ayushgupta9906/Effi-QUI-ADAS-Four-Wheel-Fully-Electric-Vehicle---TGW-ZHCET/23056_Green Warriors_Document Package (1)/23056_Green Warriors_Document Package/23056_Green Warriors_Cost Report.xls

Sheet: Guidelines
Cost Report Guidelines
1. Introduction
1.1 | The cost report is a tool provided with the objective to calculate the cost of the Efficycle. (For this purpose teams can assume that the same Efficycle is manufactured by a fictitious firm.)
1.2 | The cost of vehicle should be calculated for all the fabrication work including the work which is done by the team itself. This also includes cost of the old parts used in vehicle. For such parts, the current cost of the same part in market must be entered in the Cost Report.
1.3 | Teams should calculate the cost of the efficycle considering the process time, material cost and manpower etc in the project in this Cost Report. Thhe reference of the cost estimation report prepared earlier may be taken while preparing this report.
2. Cost Report Data
2.1 | Definitions
2.1.1 | Block:
 | The whole efficycle can be considered as an assembly of various subsystems (e.g. Frame, drivetrain, suspension, steering, brakes, electrical circuits etc). These subsystems are defined as block in this Cost Report. The blocks are mentioned in the "INDEX SHEET" itself and same blocks must be used in the "BOM Sheet and Part List Sheet".
2.1.2 | Part Name:
 | The name of each part must be provided in the Part Name Column. The description is required to identify the unique part among same category of parts. (for example: if 2 different sizes of fasteners are used in the assembly of a subsystem like bolts of M10 and M12, then the part name must be given like "Fastener" for both with their description in the Remarks Column as "Bolt M10" and "Bolt M12" respectively). In case, only one part of its own type is being used then the description is not required. (for example: Motor)
2.1.3 | Quantity:
 | Quantity denotes how many times the same part is used in a block. For the same part the costs are calculated by applying quantity. (if teams are using 3 sprockets of same specification and same cost, then it must be considered as the single part whereas quantity will be 3)
2.1.4 | Procurement Cost:
 | Procurement cost are the cost of part/material purchased directly from the market. Procurement costs are considered per item or per unit quantity only in the Cost Report. If the parts are procured in lot or mass, then per item cost will be calculated by dividing the number of parts or amount of material to the total procurement cost of that lot.
2.1.5 | Manufacturing cost:
 | cost of all fabricated parts will be calculated by taking all number of operation used in fabricating that part or subassembly in account (made by joining few parts together). The cost of fabrication will be calculated by using "Cost Calculation Sheet"
2.2 | Introduction to Cost Report Format
2.2.1 | Sheet 1: Guidelines
 | Teams must go through this sheet to make a complete understanding with this Cost Report format. All guidelines are mentioned in this sheet, in any case of discrepancy during cost calculations the teams must refer this sheet to avoid mistakes.
2.2.2 | Sheet 2: Index Sheet
 | Index sheet contains the standard rate of fabrication processes. Teams should use these rates to calculate the cost of their vehicle. If the cost of any operation is not present in the index sheet the teams can use rates as per the local market.
2.2.3 | Sheet 3: Main Sheet
 | In this sheet teams will provide their Team ID in highlighted cell. Team Details such as Team Name, Vehicle Number, Insitute Name, Captain Name and Faculty Advisor Name shall appear automatically. At bottom of sheet, names of Report Author and Report Co-author must be entered.
 | Main sheet represents the summarized cost of the vehicle in terms of procurement cost, manufacturing cost, total cost of the vehicle and total number of parts used in the vehicle.
2.2.4 | Sheet 4: BOM Sheet
 | This is main BOM sheet in which the details of all parts or subassemblies used in the vehicle should be filled. Hence teams must mention the details very carefully and accurately. (an example is shown for example in "Sample BOM" sheet)
 | This sheet calculate the following data:
2.2.5 | Number of parts in subsystem:
 | The number of parts are calculated as per the details filled in "BOM Sheet"
2.2.6 | Total Procurement Cost:
 | This cost is the actual cost incurred in procurement of required number of parts for efficycle. The cost incured in procurement of all parts and raw materials should be included in the procurement cost for that part/material
2.2.7 | Total Manufacturing Cost:
 | This is the cost incurred in manufacturing or customizing the parts or subassemblies. The cost of all fabrication processes must be included in the manufacturing cost of that part.
2.2.8 | Sheet 5: Cost Calculations Sheet
 | This sheet provides a method to calculate the cost of subsystems. This sheet will be used to calculate the cost of each manufactured or customized parts.
 | Name of such part or subassemblies should be provided in the description field (an example is shown in "Sample Cost Calculation" sheet).
 | In this sheet there are two tables for each item, namely Procurement Cost Calculations and Manufacturing Cost Calculation.
 | Procurement Cost Table can be used to calculate the cost of raw material as well as the cost of parts that can be used to fabricate customized parts.
 | Manufacturing Cost Table can be used to calculate the total cost of manufacturing operations used in the fabrication of a particular item. Teams must carefully understand their fabrication processes to accurately calculate the cost of manufactured part.
2.2.9 | Sheet 6: Part List Sheet
 | In this sheet, the list of reused parts and in-house fabricated parts shall be inlcuded. A. Reused Parts are those which are being used by team from the previous year vehicle or resale parts procured from market. Refer 2.3.4 & 2.3.5. B. In-House Fabricated Parts are those parts which are made in-house by the team (such as frame, seat/motor mounting etc). The const of these items shall be calculated in the "Cost Calculations Sheet".
2.3 | Other Information
2.3.1 | The cost of parts must be the retail prices excluding VAT or any other tax.
2.3.2 | The labor cost are not to be mentioned separately for manufacturing operations, it is already included in the standard rates of operations
2.3.3 | But in case of Vehicle assembly, labour cost will be entered separately in the BOM sheet (can be calculated from Cost Calculation Sheet)
2.3.4 | The cost of resale/discounted price cannot be considered for calculation for any of the item. However teams are free to use resale parts in their vehicle but the cost reflected in this report must be same as that of a new part purchased form the retailer.
2.3.5 | For reused parts, the current market price of that item in the market must be used for calculation. A quotaion or estimate from the retailer may be produced as the supporting document. Online or computerized quotations will also work.
2.3.6 | Cost of consumable items (like filler wire, grease, oils etc) need not to be included in the Cost Report.
3. Format
3.1 | The teams must use the format published by Technical Committee only.
3.2 | Cost Report must be submitted in .xls or .xlsx format only. No other format like .xlsm(Macros enabled), .pdf will not be considered.
3.3 | Report must not contain any image, media file or digital signatures etc.
3.4 | For any query regarding Cost Report format, teams are advised to write to efficycle.technical@saenis.org
4. How to Make Your Cost Report?
4.1 | Step-1: First Read all the guidelines given in the Guidelines Sheet' carefully otherwise you may make a mistake in report creation.
4.2 | Step-2: Get the part list from your 'Fabrication Plan' in 4 categories 1). Puchased Parts 2). Fabricated Parts 3). Customized Parts 4). Reused parts.
4.3 | Step-3: Then identify their blocks as per the index sheet.
4.4 | Step-4: For parts which are in-house fabricated, customized after procurement and fabricated with raw material procured from market, calculate the cost of procurement (per item) and manufacturing cost (per item) in 'Cost Calculation Sheet'. These calculations should be done for each part in separate table. To add more tables in 'Cost Calculation Sheet' follow the procedure given in separate sheet.
4.5 | Step-5: Reflect the cost of procurement and cost of manufacturing in 'BOM Sheet' with the help of calculations done in 'Cost Calculation Sheet'. Mention the quantity of parts and the total manufacturing cost and procurement cost shall be calculated automatically in blue columns. Do not edit formula etc. To add more parts in the list just insert more rows at the bottom and drag the formula from above row.
4.6 | Step-6: For purchased parts, mention the cost of per item directly in 'BOM Sheet' as there is no manufacturing involved. The cost entries as mentioned in 4.5 & 4.6 shall be done for each block together for easy evaluation.
4.7 | Step-7: The total Manufacturing Cost, Procurement Cost, Total Vehicle Cost and Total Number of Parts used in vehicle will appear automatically in the 'Main Sheet'.
4.8 | Step-8: Select your Team ID from the given drop down list in the cell. The details of Team Name, Vehicle Number and College Name, Captain Name and Faculty Advisor Name will appear automatically.
4.9 | Step-9: Write down the Name of Report Author and Co-author in the space provided. Submit this sheet through email as per the instructions given in section 5 below.
5. Report Submission
5.1 | Report will be submitted in MS Excel format only (.xls or .xlsx). Any other format such as .pdf, .doc or macro enabled workbooks .xlsm will not be considered.
5.2 | Teams must save their cost report will file name Team ID_Team Name_Cost Report.
5.3 | This report must be submitted as a part of documentation package as per documentation guidelines which will be released later.
Note : Expect the 3 main slides (Main sheet, BOM, Cost calcluation - Which are highlighted in green colour tab) remaing slides including this guidelines should be deleted before submission.

Sheet: Index Sheet
Operation | Unit | Rate (INR) | Blocks
Lathe | per hour | 100 | Frame
CNC | per hour | 200 | Drivetrain
TIG Welding | per mm | 0.4 | Steering
SMAW Welding | per mm | 0.3 | Suspension
Gas Welding/Gas Cutting | per mm | 0.4 | Brakes
Drill per hole | upto 5mm depth | 5 | Wheel & Tyre
Drill per hole | more than 5mm depth | 10 | Seats
Reaming | per hour | 100 | Others
Boring | per mm depth | 1
Grinding | per hour | 35
Profiling | per cut | 5
Riveting | per rivet | 5
Shaper | per hour | 120
Milling | per hour | 100
Shearing | per cut | 5
Cutting | per cut | 5
Gear Hobbing | per 10mm width per teeth | 50
Rack Cutting | per 10mm depth per teeth | 50
Labour | per hour | 35

Sheet: Main Sheet
SAE NIS EFFICYCLE 2023_Cost Report
Team Name |  | Team ID | Vehicle Number
GREEN WARRIORS |  | 23056 | 56
Institute Name, City |  | ZHCET, AMU, ALIGARH
Procurement Cost |  | 120330
Manufacturing Cost |  | 22815
Total Cost |  | 143145
Total No. of Parts |  | 90
Report Author | Abdus Samad Suhail
Report Co-author | Mohd Munazir Mairaj
Team Captain | Mohd Munazir Mairaj
Faculty Advisor | Nafees Ahmad
Attached:
1. BOM Sheet
2. Cost Calculations Sheet

Sheet: BOM1
Block | Part Name or Description | Quantity | Procurement Cost (Per item) | Total Procurement Cost | Manufacturing Cost (Per Item) | Total Manufacturing Cost | Total Cost | Remarks
Frame | Base Frame | 1 | 4000 | 4000 | 500 | 500 | 4500
Frame | Roll over | 1 | 6000 | 6000 | 600 | 600 | 6600
Frame | Seat Frame | 1 | 800 | 800 | 200 | 200 | 1000
Frame | Side protection | 2 | 800 | 1600 | 100 | 200 | 1800
Frame | Utility mounting | 4 | 5 | 20 | 5 | 20 | 40
Frame | Suspention Mounting | 48 | 2 | 96 | 4 | 192 | 288
Frame | Bolts | 40 | 5 | 200 | 0 | 0 | 200 | M-8
Frame | Nuts | 40 | 3 | 120 | 0 | 0 | 120 | M-8
Frame | Motor Mounting | 1 | 15 | 15 | 50 | 50 | 65
Frame | Towing Hook | 1 | 15 | 15 | 15 | 15 | 30
 |  |  |  |  |  |  |  | 3Point
Seats | OEM belt | 1 | 700 | 700 | 0 | 0 | 700
Seats | Seats(including back support) | 2 | 750 | 1500 | 0 | 0 | 1500
 |  |  |  |  |  |  |  | 8 coils hardened Steel
Suspension | Shock absorbers | 4 | 300 | 1200 | 250 | 1000 | 2200
Suspension | Bush | 20 | 6 | 120 | 0 | 0 | 120 | M-12
Suspension | Washer | 28 | 1 | 28 | 0 | 0 | 28 | M-8
Suspension | Nuts | 28 | 5 | 140 | 0 | 0 | 140 | M-8
Suspension | Bolts | 28 | 8 | 224 | 0 | 0 | 224
Suspension | Heim Joint | 20 | 100 | 2000 | 0 | 0 | 2000
Suspension | A arms | 8 | 60 | 480 | 10 | 80 | 560 | Hollow pipes
Wheel & Tyre | Wheel Rim | 4 | 600 | 2400 | 0 | 0 | 2400 | 12 inch
Wheel & Tyre | Tyres | 4 | 820 | 3280 | 0 | 0 | 3280 | Width 90mm
Wheel & Tyre | Bearings | 4 | 100 | 400 | 100 | 400 | 800 | Sliding Bearing
Wheel & Tyre | Knuckle(front) | 2 | 3000 | 6000 | 2100 | 4200 | 10200 | Al 6068
Wheel & Tyre | Knuckle(rear) | 2 | 3000 | 6000 | 2000 | 4000 | 10000 | Al 6068
Wheel & Tyre | Wheel Hub | 4 | 3000 | 12000 | 2000 | 8000 | 20000
Wheel & Tyre | Nuts | 16 | 5 | 80 | 5 | 80 | 160 | M-10
Wheel & Tyre | Bolts | 16 | 8 | 128 | 8 | 128 | 256 | M-10
Steering | Rack | 1 | 2000 | 2000 | 1000 | 1000 | 3000 | Al 8082 for lighter Rack
Steering | Pinion | 1 | 2000 | 2000 | 1000 | 1000 | 3000
Steering | Universal Joint | 1 | 450 | 450 | 0 | 0 | 450
Steering | Steering Column | 1 | 300 | 300 | 50 | 50 | 350 | Steel tubes (608mm)
Steering | Steering Wheel | 1 | 800 | 800 | 200 | 200 | 1000 | 12 inch dia
Steering | Casing | 1 | 1000 | 1000 | 500 | 500 | 1500
Steering | Steering Hub | 1 | 600 | 600 | 0 | 0 | 600
Steering | Heim Joints | 4 | 200 | 800 | 0 | 0 | 800
Steering | Tie Rod | 2 | 70 | 140 | 50 | 100 | 240

Sheet: BOM2
Block | Part Name or Description | Quantity | Procurement Cost (Per item) | Total Procurement Cost | Manufacturing Cost (Per Item) | Total Manufacturing Cost | Total Cost | Remarks
Brakes | Disc Brake Rotor | 4 | 999 | 3996 | 0 | 0 | 3996
Brakes | Brake Calliper | 4 | 650 | 2600 | 0 | 0 | 2600
Brakes | Brake lines | 4 | 600 | 2400 | 0 | 0 | 2400 | Steel Braided
Brakes | Master cylinder | 1 | 750 | 750 | 0 | 0 | 750
Brakes | Brake Fluid | 4 | 499 | 1996 | 0 | 0 | 1996
Brakes | Brake pedal | 1 | 100 | 100 | 150 | 150 | 250 | EN-24
Brakes | Nuts | 8 | 3 | 24 | 0 | 0 | 24 | M-7
Brakes | Bolts | 8 | 5 | 40 | 0 | 0 | 40 | M-7
Others | Arduino Uno | 7 | 500 | 3500 | 0 | 0 | 3500
Others | LED TFT 5 inches/TFT3 5"Screen | 1 | 1500 | 1500 | 0 | 0 | 1500
Others | Hall Sensor | 2 | 50 | 100 | 0 | 0 | 100
Others | Jumper Wires | 4 | 1.5 | 6 | 0 | 0 | 6
Others | Buzzer | 8 | 12 | 96 | 0 | 0 | 96
Others | LED RGB | 20 | 1 | 20 | 0
Others | Memory card | 1 | 320 | 320 | 0 | 0 | 320 | 32 GB
Others | GSM module with RS232 interface and SMA antenna | 1 | 775 | 775 | 0 | 0 | 775
Others | Signal Apmlifying Module | 1 | 100 | 100 | 0 | 0 | 100
Others | Load Sensor | 1 | 1000 | 1000 | 0 | 0 | 1000
Others | Head Lights | 2 | 100 | 200 | 0 | 0 | 200
Others | Break lights | 2 | 150 | 300 | 0 | 0 | 300
Others | Indicators | 4 | 50 | 200 | 0 | 0 | 200
Others | Real time clock module | 1 | 195 | 195 | 0 | 0 | 195
Others | Transistor | 3 | 10 | 30 | 0 | 0 | 30
Others | GPS Module | 1 | 300 | 300 | 0 | 0 | 300
Others | Bluetooth speakers | 1 | 750 | 750 | 0 | 0 | 750
Others | Solar Charger controller | 1 | 370 | 370 | 0 | 0 | 370
Others | Energy Regenerartion system | 1 | 500 | 500 | 0 | 0 | 500
Others | L293D MODULE | 2 | 100 | 200 | 0 | 0 | 200
Others | Servo motor | 2 | 400 | 800 | 0 | 0 | 800
Others | Gyroscope | 1 | 200 | 200 | 0 | 0 | 200
Others | Battery | 1 | 900 | 900 | 0 | 0 | 900
Others | Solar Panel | 1 | 1900 | 1900 | 0 | 0 | 1900
Others | Ultrasonic Sensors | 10 | 200 | 2000 | 0 | 0 | 2000
Others | Infrared Sensors | 2 | 25 | 50 | 0 | 0 | 50
Others | Resistors | 20 | 5 | 100 | 0 | 0 | 100
Others | A TO B Cable | 3 | 30 | 90 | 0 | 0 | 90
Others | Raspberry pi | 1 | 5000 | 5000 | 0 | 0 | 5000
Others | Raspberry pi camera module | 1 | 600 | 600 | 0 | 0 | 600
Others | Vibration sensor | 4 | 150 | 600 | 0 | 0 | 600
Others | Current sensor | 2 | 200 | 400 | 0 | 0 | 400

Sheet: BOM3
Block | Part Name or Description | Quantity | Procurement Cost (Per item) | Total Procurement Cost | Manufacturing Cost (Per Item) | Total Manufacturing Cost | Total Cost | Remarks
Others | Magnet | 3 | 20 | 60 | 0 | 0 | 60
Others | Harness Pipe | 1 | 200 | 200 | 0 | 0 | 200
Others | Push Button | 5 | 17 | 85 | 0 | 0 | 85
Others | On and off switch | 3 | 7 | 21 | 0 | 0 | 21
Others | Charger | 1 | 3500 | 3500 | 0 | 0 | 3500
Others | Arduino nano | 3 | 500 | 1500 | 0 | 0 | 1500
Others | DRL | 1 | 375 | 375 | 0 | 0 | 375
Others | Headlight | 2 | 1700 | 3400 | 0 | 0 | 3400
Others | Tail Light | 2 | 193 | 386 | 0 | 0 | 386
Others | Solder Iron kit | 1 | 499 | 499 | 0 | 0 | 499
Drivetrain | Differential | 1 | 5430 | 5430 | 4570 | 4570 | 10000
Drivetrain | Drive shaft | 2 | 500 | 1000 | 625 | 1250 | 2250
Drivetrain | Motor Kit | 1 | 9830 | 9830 | 0 | 0 | 9830
Drivetrain | Differential Mount | 2 | 700 | 1400 | 350 | 700 | 2100

Sheet: Cost Calculations
Subassemblies and Customized Parts Cost Calculation Sheet
Part Name: |  | Frame
Procurement Cost Calculation
S. No. | Description | Material | Quantity | Unit | Rate | Cost
1 | Pipe | Mild Steel-1018 | 120 | ft | 90 | 10800
Total procurement Cost of |  |  |  | Frame |  | 10800
Manufacturing Cost Calculation
S. No. | Process |  | Quantity | Unit | Rate | Cost
1 | TIG Welding |  | 2000 | per mm | 0.4 | 800
2 | Cutting |  | 72 | per cut | 5 | 360
3 | Grinding |  | 2 | per hour | 35 | 70
Total Manufacturing Cost of |  |  |  | Frame |  | 1230
Total Cost of |  |  |  | Frame |  | 12030
Part Name: |  | Suspension
Procurement Cost Calculation
S. No. | Description | Material | Quantity | Unit | Rate | Cost
1 | A-Arms | Seamless AISI 4130 | 5 | m | 100 | 500
2 | Shock Absorbers | Hardened Steel | 4 | units | 550 | 2200
Total procurement Cost of |  |  |  | Suspension |  | 2700
Manufacturing Cost Calculation
S. No. | Process |  | Quantity | Unit | Rate | Cost
1 | Cutting |  | 32 | per cut | 5 | 160
2 | Tapping |  | 16 | per tap | 5 | 80
Total Manufacturing Cost of |  |  |  | Suspension |  | 240
Total Cost of |  |  |  | Suspension |  | 2940
Part Name: |  | Wheels and tyres
Procurement Cost Calculation
S. No. | Description | Material | Quantity | Unit | Rate | Cost
1 | Knuckle | Al6068 | 4 | units | 3000 | 12000
2 | Wheel hub | Al6068 | 4 | units | 3000 | 12000
Total procurement Cost of |  |  |  | Wheels and tyres |  | 24000
Manufacturing Cost Calculation
S. No. | Process |  | Quantity | Unit | Rate | Cost
1 | Lathe |  | 1 | per hour | 100 | 100
2 | Boring |  | 200 | per mm depth | 1 | 200
3 | CNC |  | 2 | per hour | 200 | 400
4 | Drill per hole |  | 32 | upto 5mm depth | 5 | 160
5 | Reaming |  | 0.34 | per hour | 100 | 34
Total Manufacturing Cost of |  |  |  | Wheels and tyres |  | 894
Total Cost of |  |  |  | Wheels and tyres |  | 24894
 | Part Name: | Steering
Procurement Cost Calculation
S. No. | Description | Material | Quantity | Unit | Rate | Cost
1 | Rack and pinion | Al8082 | 4 | units | 3000 | 12000
2 | Steering column | Al6068 | 4 | units | 300 | 1200
3 | Steering Wheel | Al6068 | 1 | units | 800 | 800
 |  |  | Total procurement Cost of | Steering |  | 14000
 |  |  | Manufacturing Cost Calculation
S. No. | Process |  | Quantity | Unit | Rate | Cost
1 | Rack Cutting |  | 36 | per 10mm depth per teeth | 50 | 1800
2 | Lathe |  | 0.083 | per hour | 100 | 8.3
3 | Drill per hole |  | 1 | upto 5mm depth | 5 | 5
 |  |  | Total Manufacturing Cost of | Steering |  | 1813.3
 |  |  | Total Cost of | Steering |  | 15813.3
 | Part Name: | Drivetrain
 |  |  | Procurement Cost Calculation
S. No. | Description | Material | Quantity | Unit | Rate | Cost
1 | Differential | Cast Iron | 1 | units | 7500 | 7500
2 | Differential shaft | Cast Iron | 2 | units | 1000 | 2000
3 | Differential mount | Al6082 | 2 | units | 300 | 600
 |  |  | Total procurement Cost of | Drivetrain |  | 10100
 |  |  | Manufacturing Cost Calculation
S. No. | Process |  | Quantity | Unit | Rate | Cost
1 | Gear hobbing |  | 50 | per 10mm width per teeth | 50 | 2500
2 | Profiling |  | 46 | per cut | 5 | 230
3 | Milling |  | 1 | per hour | 100 | 100
 |  |  | Total Manufacturing Cost of | Drivetrain |  | 2830
 |  |  | Total Cost of | Drivetrain |  | 12930
0

Sheet: Sample BOM
Block | Part Name/Description | Quantity | Procurement Cost (Per item) | Total Procurement Cost | Manufacturing Cost (Per Item) | Total Manufacturing Cost | Total Cost | Remarks
Frame | Main Frame | 1 | 3000 | 3000 | 740 | 740 | 3740
Frame | Mounting Points | 20 | 0 | 0 | 28 | 560 | 560
Drivetrain | Battery | 1 | 600 | 600 | 0 | 0 | 600
Drivetrain | Motor | 1 | 1500 | 1500 | 0 | 0 | 1500
Drivetrain | Sprockets | 3 | 200 | 600 | 0 | 0 | 600
Drivetrain | Drive Axle | 1 | 900 | 900 | 38 | 38 | 938
Driver Seat | Seat | 2 | 800 | 1600 | 0 | 0 | 1600
Wheel & Tyre | Wheels | 3 | 800 | 2400 | 0 | 0 | 2400 | Rim & Tyres
 | Read Comments at B2, B7
Total |  | 8 |  | 10600 |  | 1338 | 11938

Sheet: Sample Cost Calculations
Subassemblies and Customized Parts Cost Calculation Sheet |  |  |  |  |  |  | Read comments on G8, F12, F14, D15, G16, B23.
Part Name: |  | Frame
Procurement Cost Calculation
S. No. | Description | Material | Quantity | Unit | Rate | Cost
1 | Pipe | Mild Steel-1020 | 50 | ft | 60 | 3000
Total procurement Cost of |  |  |  | Frame |  | 3000
Manufacturing Cost Calculation
S. No. | Process |  | Quantity | Unit | Rate | Cost
1 | Cutting |  | 24 | per cut | 5 | 120
2 | Grinding |  | 3 | per hour | 35 | 105
3 | Pipe Bending |  | 14 | per bend | 10 | 140
4 | SMAW Welding |  | 1250 | per mm | 0.3 | 375
Total Manufacturing Cost of |  |  |  | Frame |  | 740
Total Cost of |  |  |  | Frame |  | 3740
Part Name: |  | Drive Axle
Procurement Cost Calculation
S. No. | Description | Material | Quantity | Unit | Rate | Cost
1 | Axle | - | 2 | No. | 450 | 900
Total procurement Cost of |  |  |  | Drive Axle |  | 900
Manufacturing Cost Calculation
S. No. | Process |  | Quantity | Unit | Rate | Cost
1 | Cutting |  | 2 | per cut | 5 | 10
2 | TIG Welding |  | 70 | per mm | 0.4 | 28
Total Manufacturing Cost of |  |  |  | Drive Axle |  | 38
Total Cost of |  |  |  | Drive Axle |  | 938
Part Name:
Procurement Cost Calculation
S. No. | Description | Material | Quantity | Unit | Rate | Cost
Total procurement Cost of |  |  |  |  |  | 0
Manufacturing Cost Calculation
S. No. | Process |  | Quantity | Unit | Rate | Cost
Total Manufacturing Cost of |  |  |  |  |  | 0
Total Cost of |  |  |  |  |  | 0
Note: For more parts, copy the above tables and paste in the below cells. To add more rows in a table, Insert a row, then copy and paste the formula from above cells.
