ayushgupta9906/Effi-QUI-ADAS-Four-Wheel-Fully-Electric-Vehicle---TGW-ZHCET/main assembly/steering/Tie rod assembly .SLDPRT

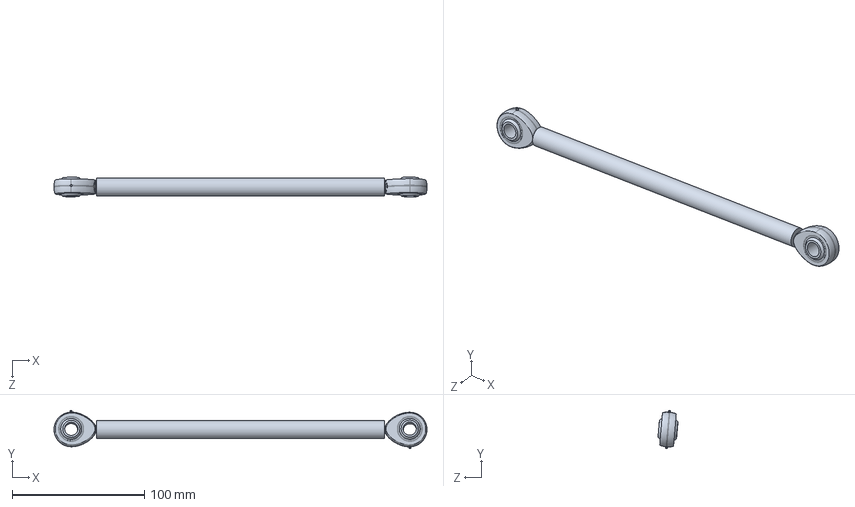
[picture p101: CAD file, 2024-04-30]
main assembly/steering/Tie rod assembly .SLDPRT
282.0 x 29.1 x 15.2 mm
