ayushgupta9906/Effi-QUI-ADAS-Four-Wheel-Fully-Electric-Vehicle---TGW-ZHCET/main assembly/suspension and wheels/front wheels/front left tyre full assembly.SLDASM

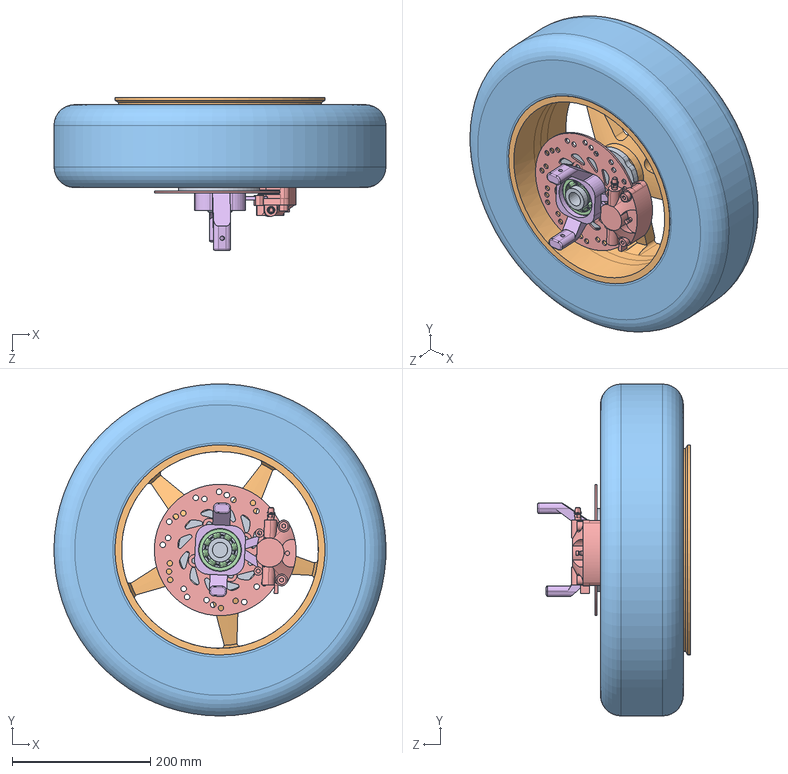
[picture p102: CAD file, 2024-04-30]
main assembly/suspension and wheels/front wheels/front left tyre full assembly.SLDASM
479.9 x 479.8 x 220.8 mm
Wheel Hub
rim
tyre
ball_bearing
brake assembly
Rear Knuckle left
