ayushgupta9906/Effi-QUI-ADAS-Four-Wheel-Fully-Electric-Vehicle---TGW-ZHCET/main assembly/steering/steering design/steering assembly.SLDASM

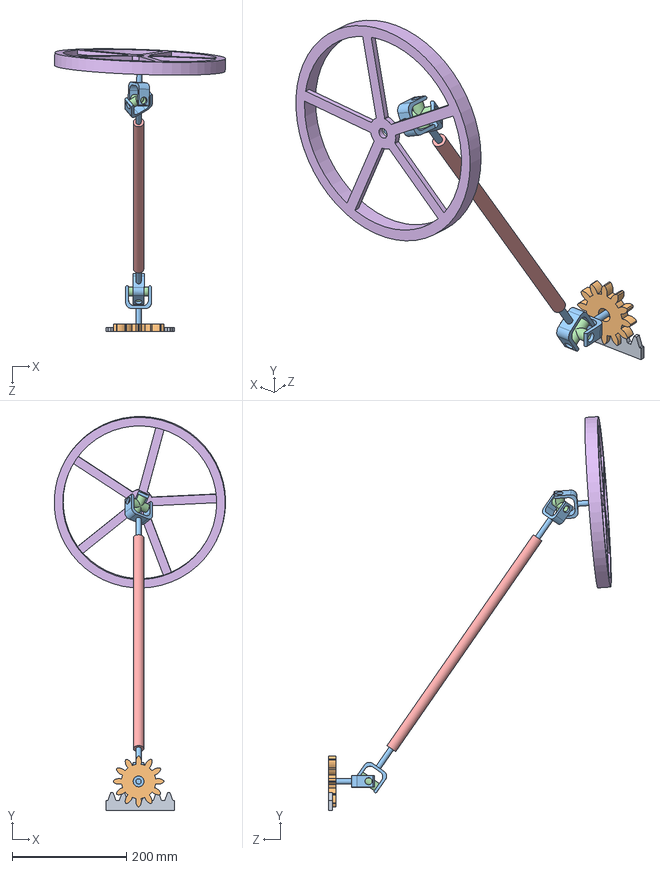
[picture p103: CAD file, 2024-04-30]
main assembly/steering/steering design/steering assembly.SLDASM
300.4 x 690.9 x 495.6 mm
rack spur rectangular_am
spur gear_am
hooke's joint x 4
cross1 x 2
rod
steering wheel
