ayushgupta9906/Effi-QUI-ADAS-Four-Wheel-Fully-Electric-Vehicle---TGW-ZHCET/main assembly/suspension and wheels/A Arms/right lower A arm assembly.SLDPRT

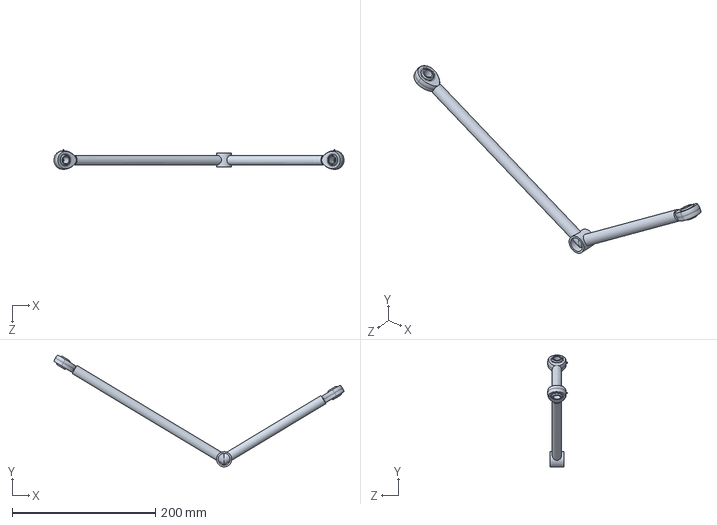
[picture p104: CAD file, 2024-04-30]
main assembly/suspension and wheels/A Arms/right lower A arm assembly.SLDPRT
405.5 x 156.4 x 27.6 mm
