ayushgupta9906/Effi-QUI-ADAS-Four-Wheel-Fully-Electric-Vehicle---TGW-ZHCET/main assembly/utility box/utility box.SLDASM

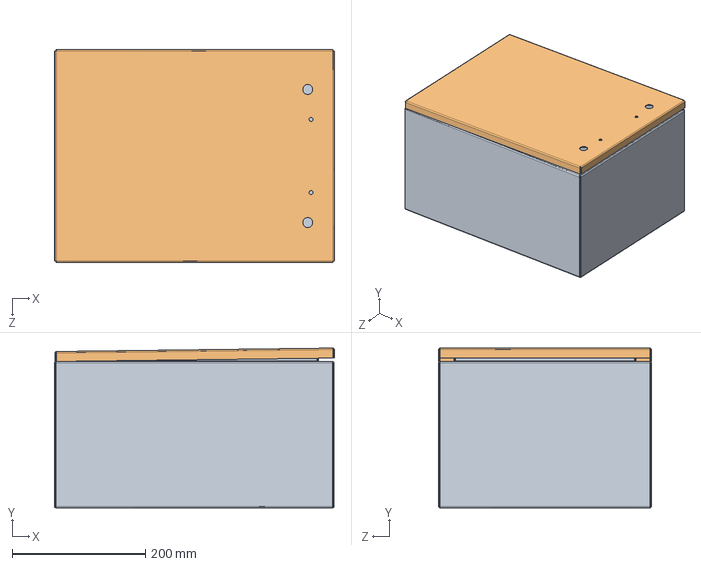
[picture p105: CAD file, 2024-04-30]
main assembly/utility box/utility box.SLDASM
420.7 x 240.2 x 320.0 mm
Part1 utility box
Part2 door
