ayushgupta9906/Effi-QUI-ADAS-Four-Wheel-Fully-Electric-Vehicle---TGW-ZHCET/main assembly/brakes/brake assembly.SLDASM

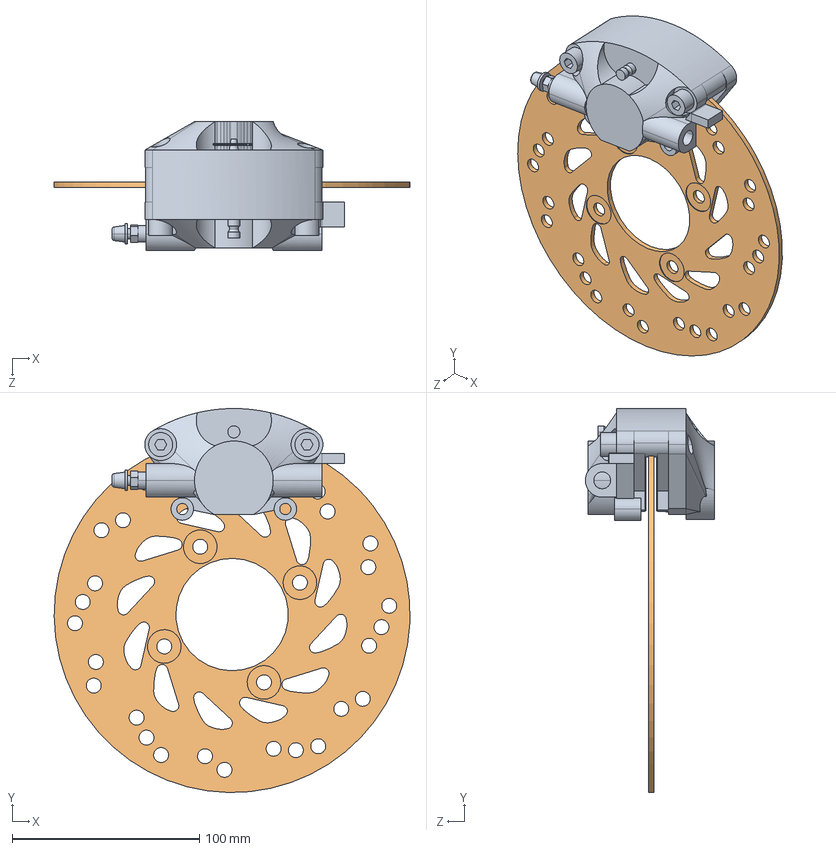
[picture p106: CAD file, 2024-04-30]
main assembly/brakes/brake assembly.SLDASM
189.9 x 205.0 x 69.0 mm
KBX caliper
effi disc brake(190mm)
