ayushgupta9906/Effi-QUI-ADAS-Four-Wheel-Fully-Electric-Vehicle---TGW-ZHCET/main assembly/powertrain/Assem3.SLDASM

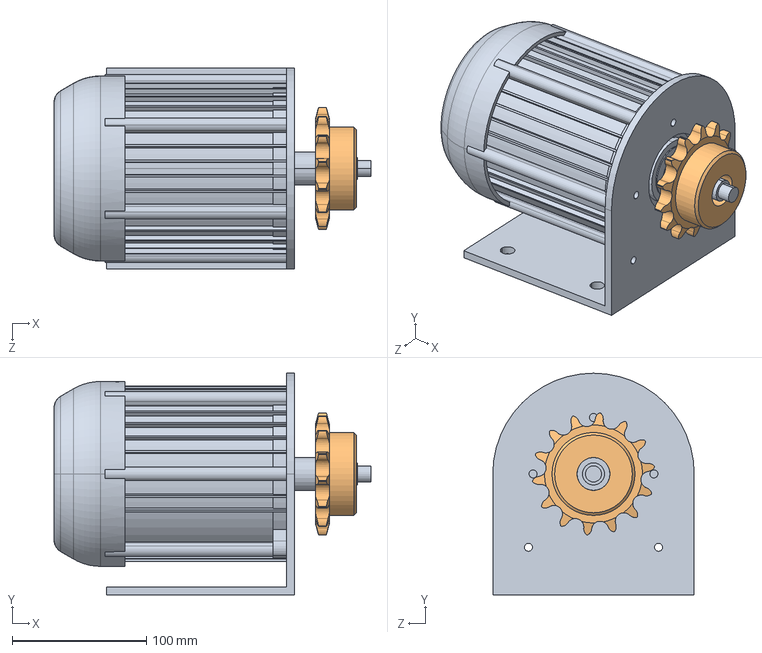
[picture p107: CAD file, 2024-04-30]
main assembly/powertrain/Assem3.SLDASM
236.0 x 165.0 x 150.0 mm
600W Motor 48V
sprocket 14 teeth single hub
