ayushgupta9906/Effi-QUI-ADAS-Four-Wheel-Fully-Electric-Vehicle---TGW-ZHCET/main assembly/steering/steering design/universal joint.SLDASM

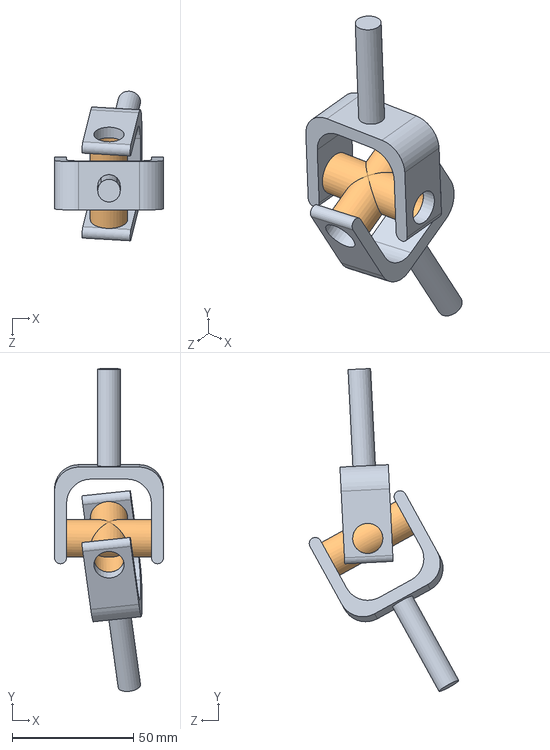
[picture p108: CAD file, 2024-04-30]
main assembly/steering/steering design/universal joint.SLDASM
45.0 x 133.3 x 61.8 mm
hooke's joint x 2
cross1
