ayushgupta9906/Effi-QUI-ADAS-Four-Wheel-Fully-Electric-Vehicle---TGW-ZHCET/main assembly/suspension and wheels/A Arms/left upper A Arm Assembly .SLDPRT

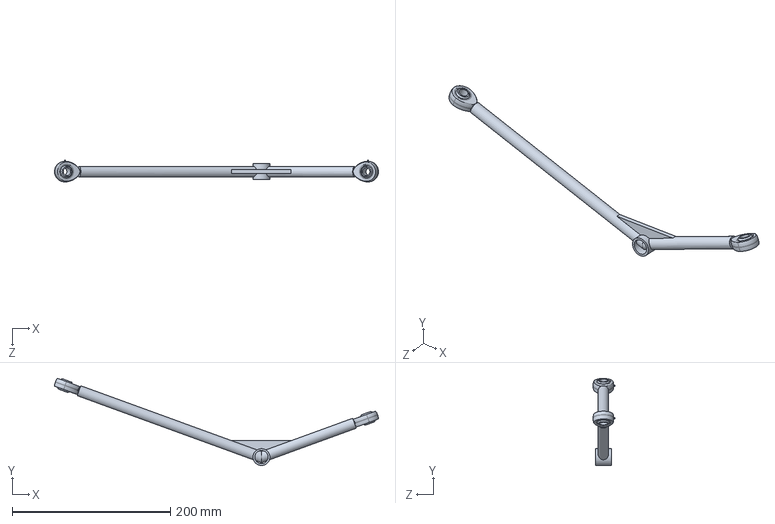
[picture p109: CAD file, 2024-04-30]
main assembly/suspension and wheels/A Arms/left upper A Arm Assembly .SLDPRT
408.9 x 109.9 x 27.6 mm
