ayushgupta9906/Effi-QUI-ADAS-Four-Wheel-Fully-Electric-Vehicle---TGW-ZHCET/main assembly/steering/steering design/rack and pinion.SLDASM

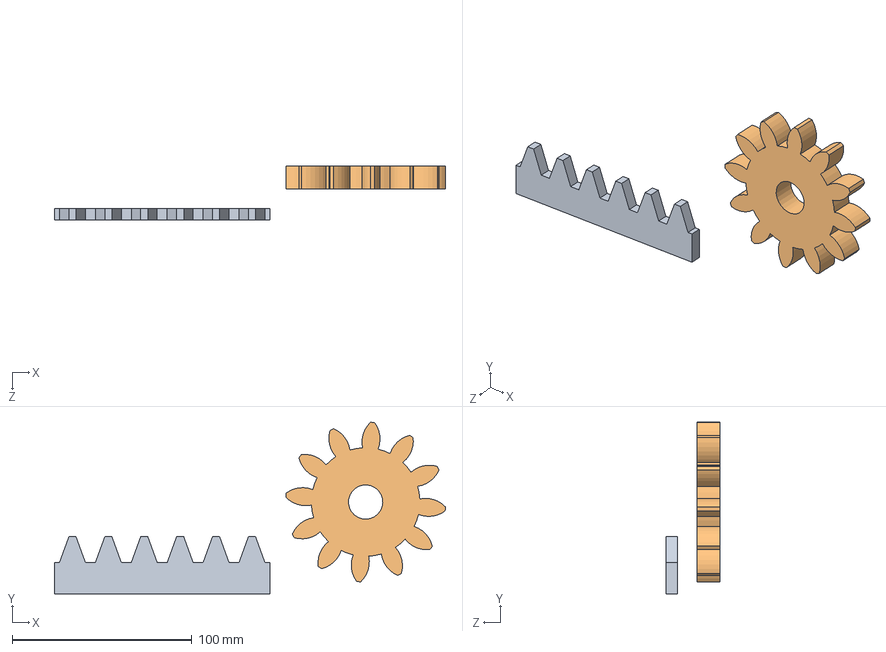
[picture p110: CAD file, 2024-04-30]
main assembly/steering/steering design/rack and pinion.SLDASM
217.2 x 95.4 x 30.0 mm
rack spur rectangular_am
spur gear_am
