ayushgupta9906/Effi-QUI-ADAS-Four-Wheel-Fully-Electric-Vehicle---TGW-ZHCET/main assembly/body works/body works front taper.SLDPRT

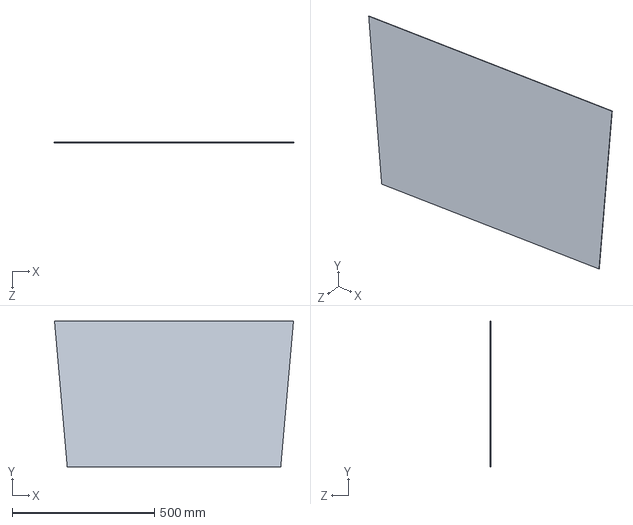
[picture p111: CAD file, 2024-04-30]
main assembly/body works/body works front taper.SLDPRT
839.4 x 511.2 x 1.50 mm
