ayushgupta9906/Effi-QUI-ADAS-Four-Wheel-Fully-Electric-Vehicle---TGW-ZHCET/main assembly/brakes/effi disc brake(190mm).SLDPRT

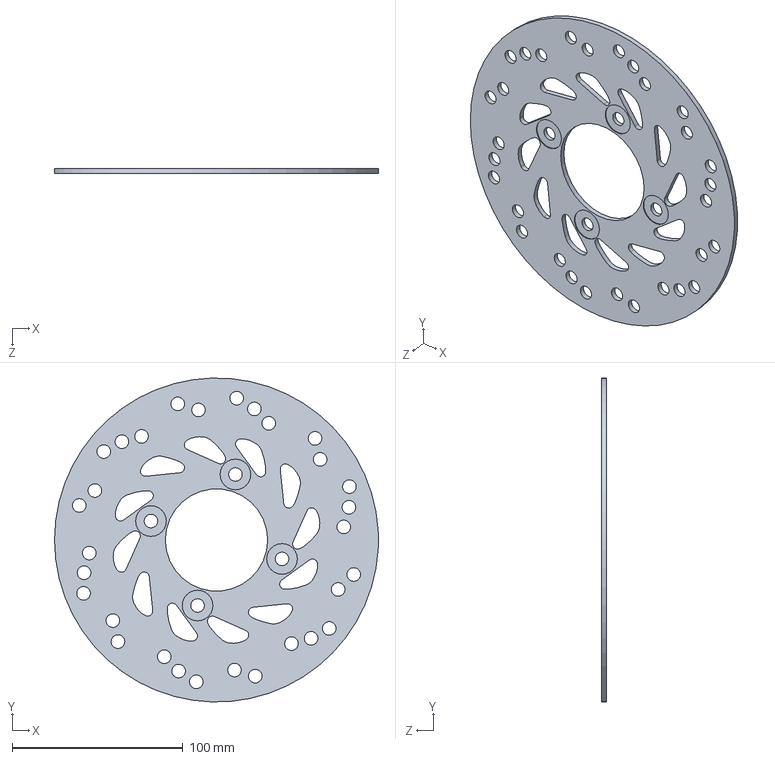
[picture p112: CAD file, 2024-04-30]
main assembly/brakes/effi disc brake(190mm).SLDPRT
190.0 x 189.9 x 3.00 mm
