ayushgupta9906/Effi-QUI-ADAS-Four-Wheel-Fully-Electric-Vehicle---TGW-ZHCET/main assembly/chassis/floor base.SLDPRT

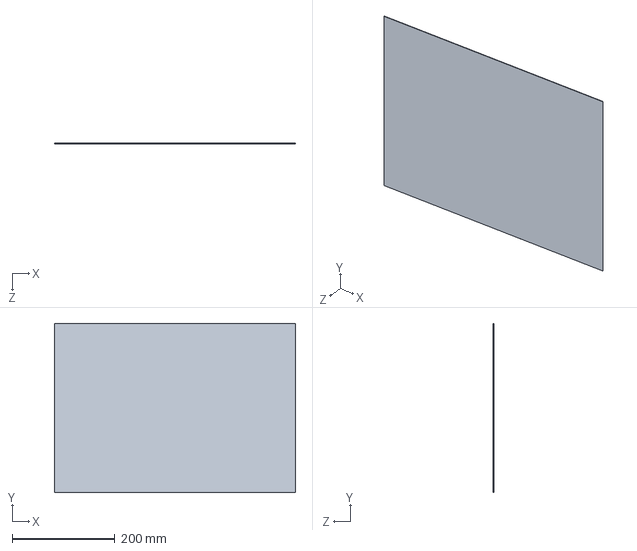
[picture p113: CAD file, 2024-04-30]
main assembly/chassis/floor base.SLDPRT
470.0 x 330.5 x 1.00 mm
