ayushgupta9906/Effi-QUI-ADAS-Four-Wheel-Fully-Electric-Vehicle---TGW-ZHCET/main assembly/knuckle/ball_bearing.SLDPRT

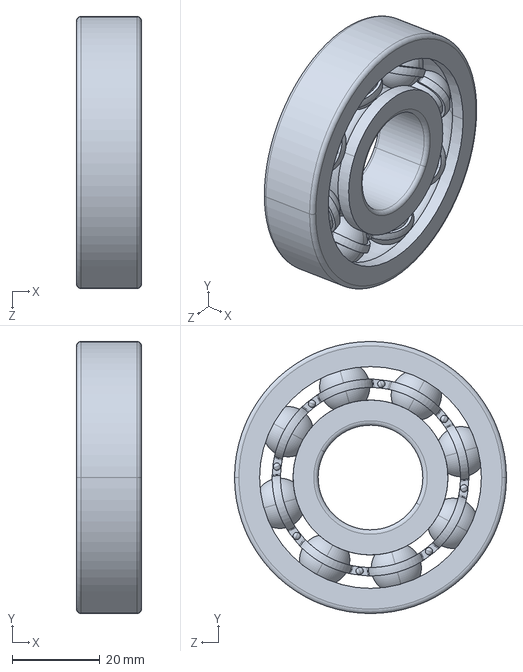
[picture p114: CAD file, 2024-04-30]
main assembly/knuckle/ball_bearing.SLDPRT
14.8 x 62.0 x 62.0 mm
