ayushgupta9906/Effi-QUI-ADAS-Four-Wheel-Fully-Electric-Vehicle---TGW-ZHCET/main assembly/powertrain/600W Motor 48V.SLDPRT

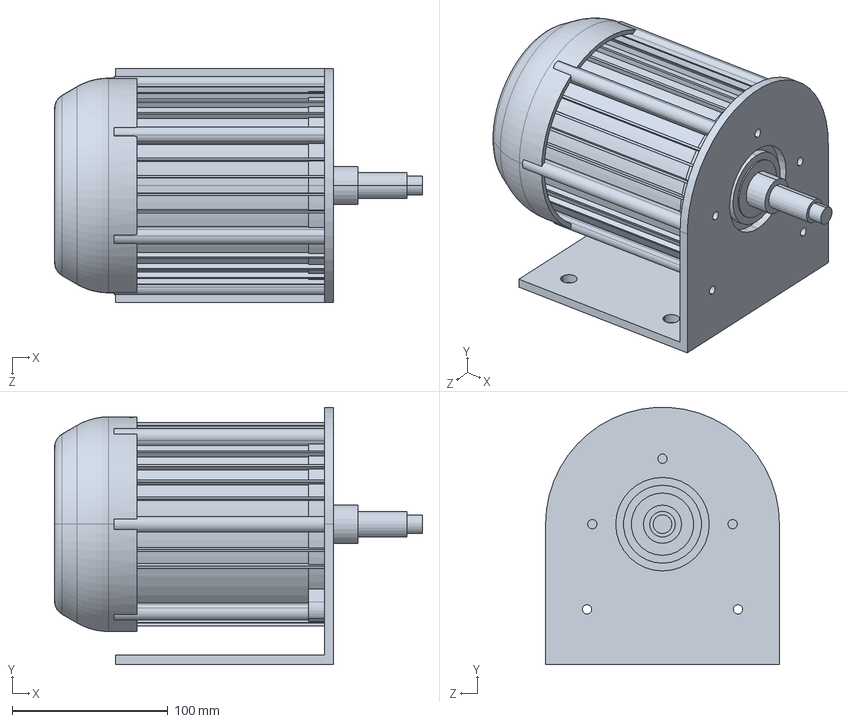
[picture p115: CAD file, 2024-04-30]
main assembly/powertrain/600W Motor 48V.SLDPRT
236.0 x 164.9 x 150.0 mm
