ayushgupta9906/Effi-QUI-ADAS-Four-Wheel-Fully-Electric-Vehicle---TGW-ZHCET/main assembly/powertrain/chain-and-sprocket.snapshot.4/Chain and Sprocket/26 Tooth .5 Pitch Sprocket .SLDPRT

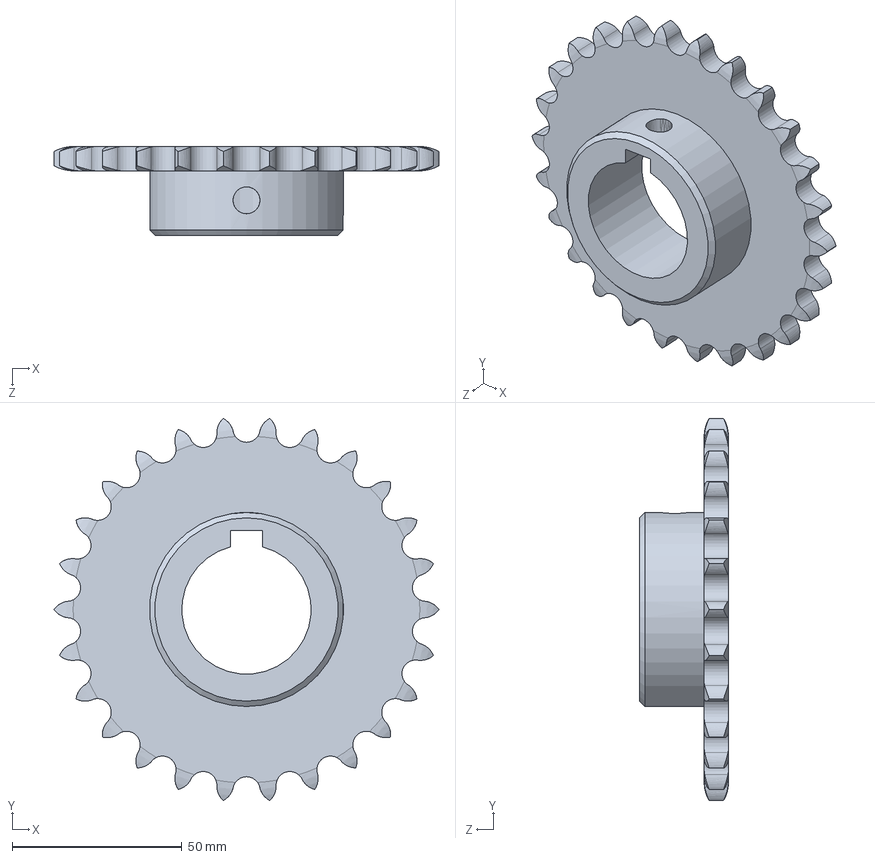
[picture p116: CAD file, 2024-04-30]
main assembly/powertrain/chain-and-sprocket.snapshot.4/Chain and Sprocket/26 Tooth .5 Pitch Sprocket .SLDPRT
113.4 x 112.6 x 26.3 mm
