ayushgupta9906/Effi-QUI-ADAS-Four-Wheel-Fully-Electric-Vehicle---TGW-ZHCET/main assembly/seat/rest back.SLDPRT

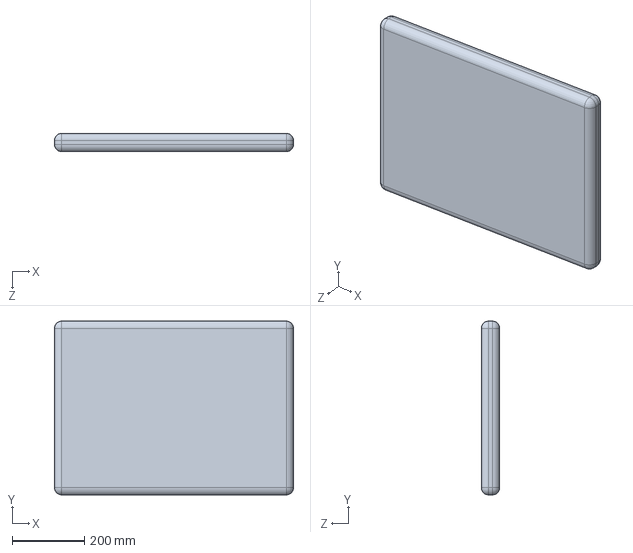
[picture p117: CAD file, 2024-04-30]
main assembly/seat/rest back.SLDPRT
660.0 x 480.0 x 50.8 mm
