ayushgupta9906/Effi-QUI-ADAS-Four-Wheel-Fully-Electric-Vehicle---TGW-ZHCET/main assembly/solar panel v2.SLDPRT

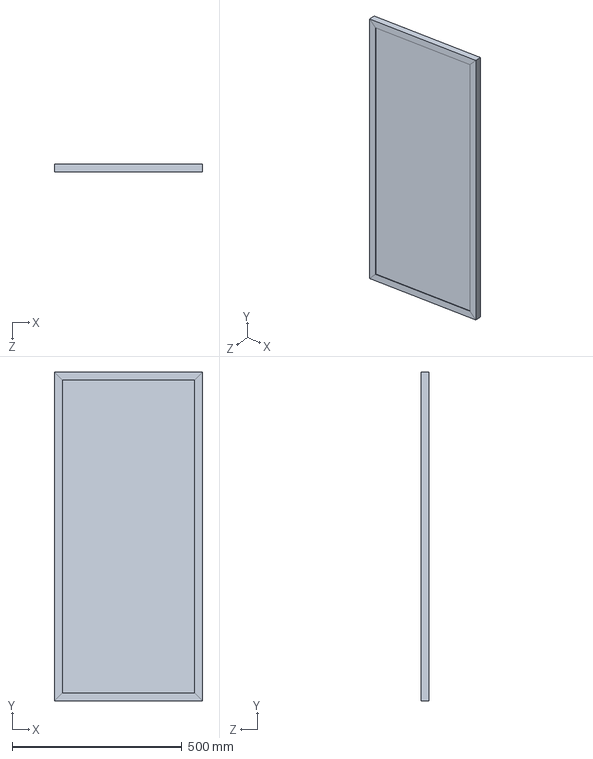
[picture p118: CAD file, 2024-04-30]
main assembly/solar panel v2.SLDPRT
436.3 x 969.6 x 24.2 mm
