ayushgupta9906/Effi-QUI-ADAS-Four-Wheel-Fully-Electric-Vehicle---TGW-ZHCET/main assembly/solar-panel-30.snapshot.2/solar panel v2.step

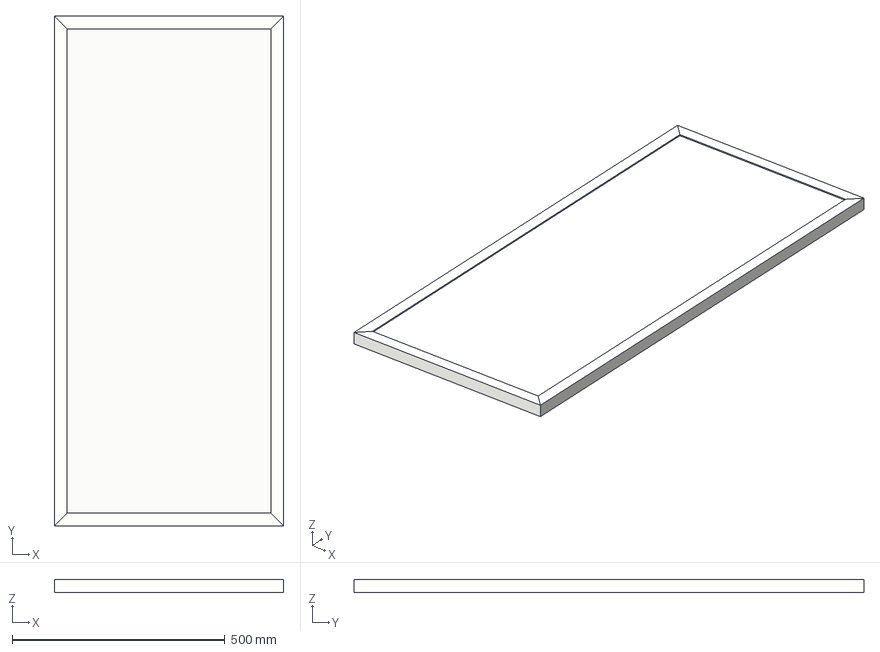
[picture p119: CAD file, 2024-04-30]
main assembly/solar-panel-30.snapshot.2/solar panel v2.step
540.0 x 1200.0 x 30.0 mm
