ayushgupta9906/Effi-QUI-ADAS-Four-Wheel-Fully-Electric-Vehicle---TGW-ZHCET/main assembly/suspension and wheels/A Arms/Small flange.SLDPRT

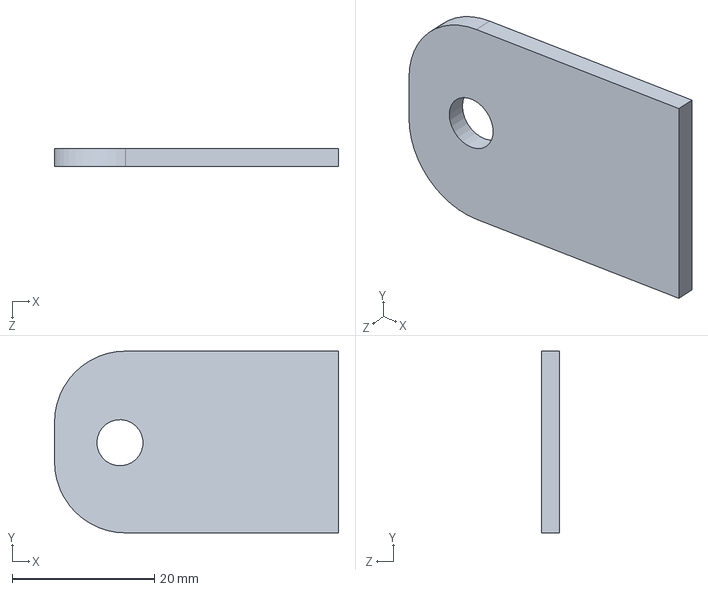
[picture p120: CAD file, 2024-04-30]
main assembly/suspension and wheels/A Arms/Small flange.SLDPRT
40.0 x 25.6 x 2.50 mm
