ayushgupta9906/Effi-QUI-ADAS-Four-Wheel-Fully-Electric-Vehicle---TGW-ZHCET/main assembly/suspension and wheels/rim.SLDPRT

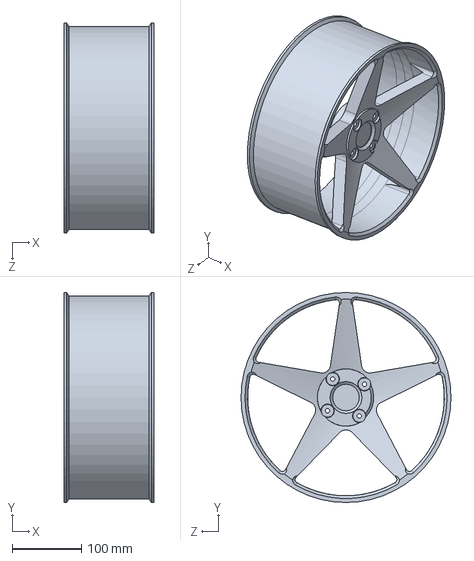
[picture p121: CAD file, 2024-04-30]
main assembly/suspension and wheels/rim.SLDPRT
129.9 x 303.7 x 303.7 mm
