ayushgupta9906/Effi-QUI-ADAS-Four-Wheel-Fully-Electric-Vehicle---TGW-ZHCET/main assembly/utility box/Part1 utility box.SLDPRT

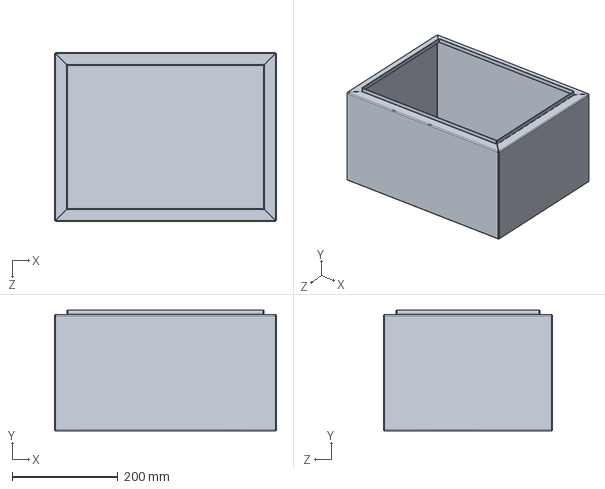
[picture p122: CAD file, 2024-04-30]
main assembly/utility box/Part1 utility box.SLDPRT
420.0 x 228.5 x 320.0 mm
