ayushgupta9906/Effi-QUI-ADAS-Four-Wheel-Fully-Electric-Vehicle---TGW-ZHCET/main assembly/body works/Side fairing.SLDPRT

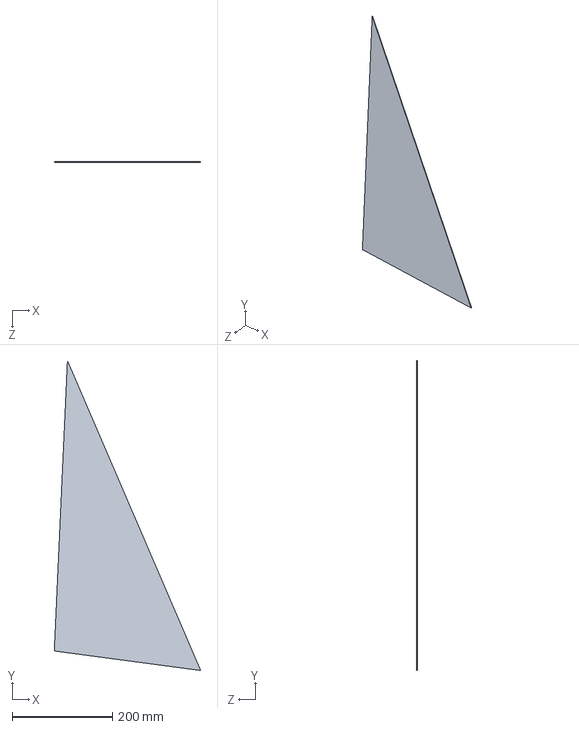
[picture p123: CAD file, 2024-04-30]
main assembly/body works/Side fairing.SLDPRT
292.9 x 620.0 x 1.50 mm
