ayushgupta9906/Effi-QUI-ADAS-Four-Wheel-Fully-Electric-Vehicle---TGW-ZHCET/main assembly/brakes/KBX caliper.SLDPRT

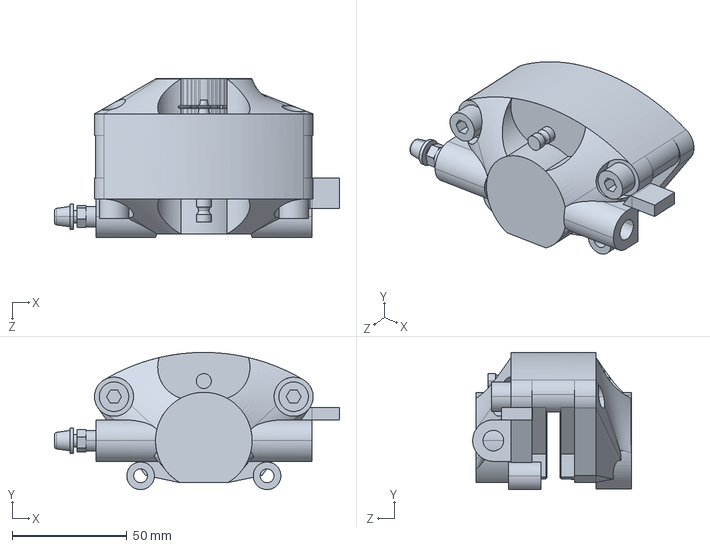
[picture p124: CAD file, 2024-04-30]
main assembly/brakes/KBX caliper.SLDPRT
123.9 x 59.7 x 69.0 mm
