ayushgupta9906/Effi-QUI-ADAS-Four-Wheel-Fully-Electric-Vehicle---TGW-ZHCET/main assembly/chassis/left door.SLDPRT

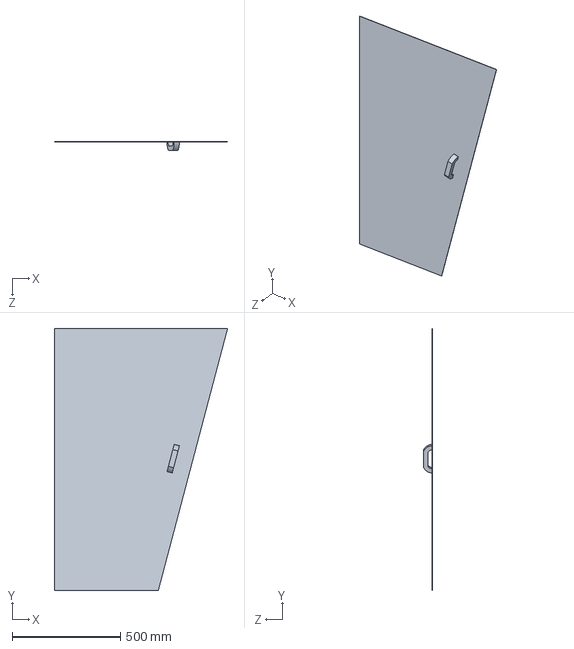
[picture p125: CAD file, 2024-04-30]
main assembly/chassis/left door.SLDPRT
800.0 x 1210.0 x 39.5 mm
