ayushgupta9906/Effi-QUI-ADAS-Four-Wheel-Fully-Electric-Vehicle---TGW-ZHCET/main assembly/knuckle/Rear Knuckle left.SLDPRT

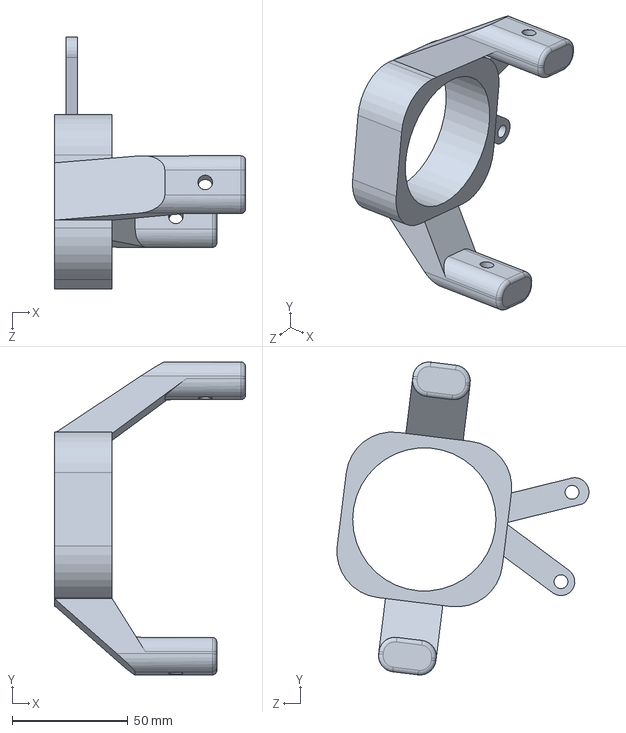
[picture p126: CAD file, 2024-04-30]
main assembly/knuckle/Rear Knuckle left.SLDPRT
82.8 x 135.5 x 109.1 mm
