ayushgupta9906/Effi-QUI-ADAS-Four-Wheel-Fully-Electric-Vehicle---TGW-ZHCET/main assembly/powertrain/sprocket 14 teeth single hub.SLDPRT

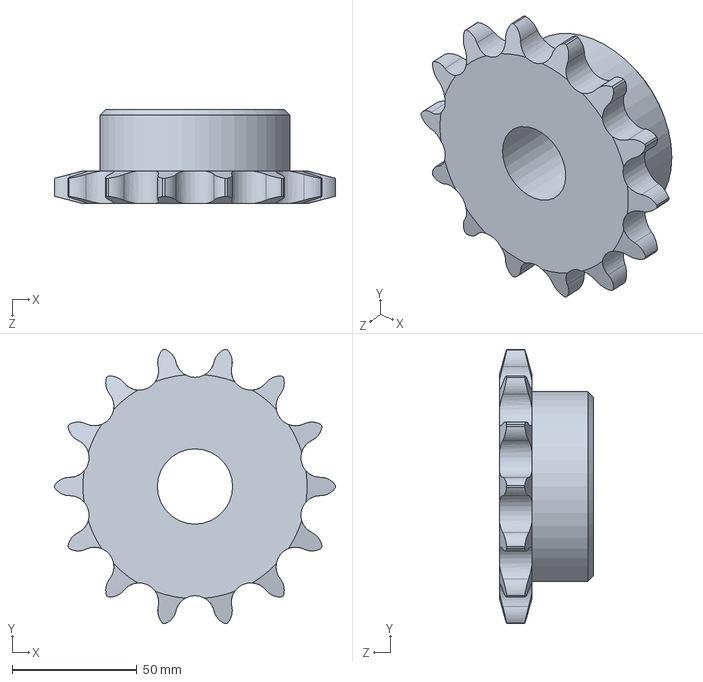
[picture p127: CAD file, 2024-04-30]
main assembly/powertrain/sprocket 14 teeth single hub.SLDPRT
112.7 x 110.0 x 37.9 mm
