ayushgupta9906/Effi-QUI-ADAS-Four-Wheel-Fully-Electric-Vehicle---TGW-ZHCET/main assembly/seat/Seat base metal top .SLDPRT

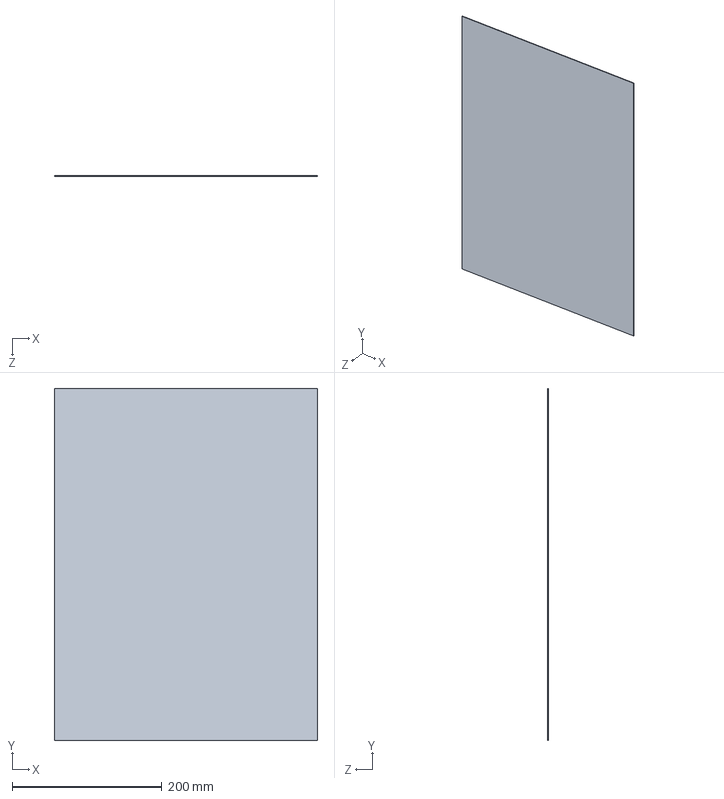
[picture p128: CAD file, 2024-04-30]
main assembly/seat/Seat base metal top .SLDPRT
351.3 x 470.0 x 1.00 mm
