ayushgupta9906/Effi-QUI-ADAS-Four-Wheel-Fully-Electric-Vehicle---TGW-ZHCET/main assembly/suspension and wheels/shock absorber.SLDPRT

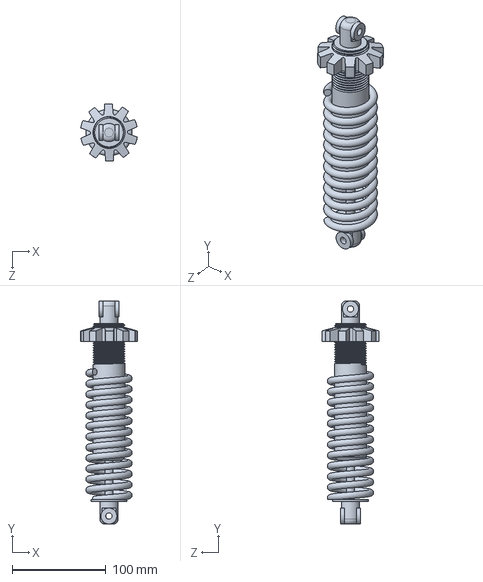
[picture p129: CAD file, 2024-04-30]
main assembly/suspension and wheels/shock absorber.SLDPRT
60.4 x 237.9 x 61.2 mm
