ayushgupta9906/Effi-QUI-ADAS-Four-Wheel-Fully-Electric-Vehicle---TGW-ZHCET/main assembly/body works/Top body works.SLDPRT

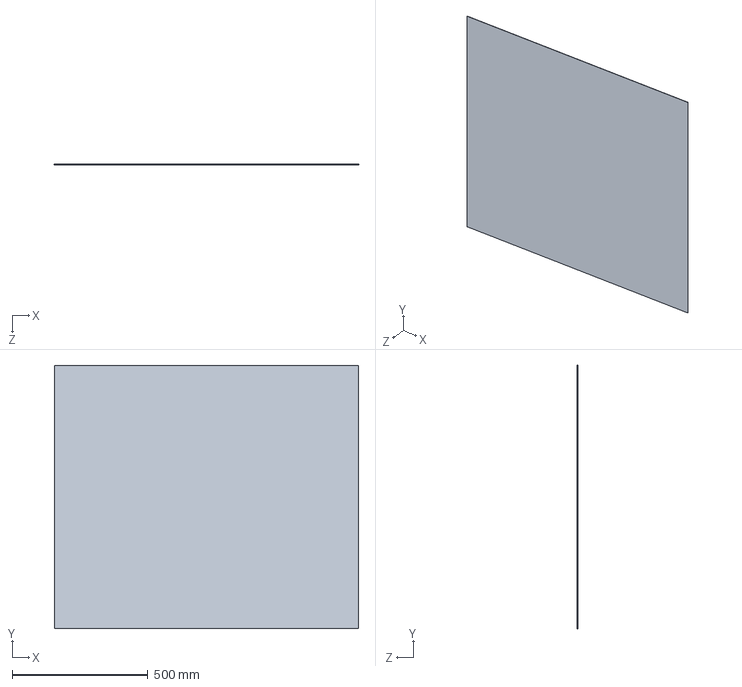
[picture p130: CAD file, 2024-04-30]
main assembly/body works/Top body works.SLDPRT
1120.0 x 970.0 x 1.50 mm
