ayushgupta9906/Effi-QUI-ADAS-Four-Wheel-Fully-Electric-Vehicle---TGW-ZHCET/main assembly/chassis/rear body above wheels.SLDPRT

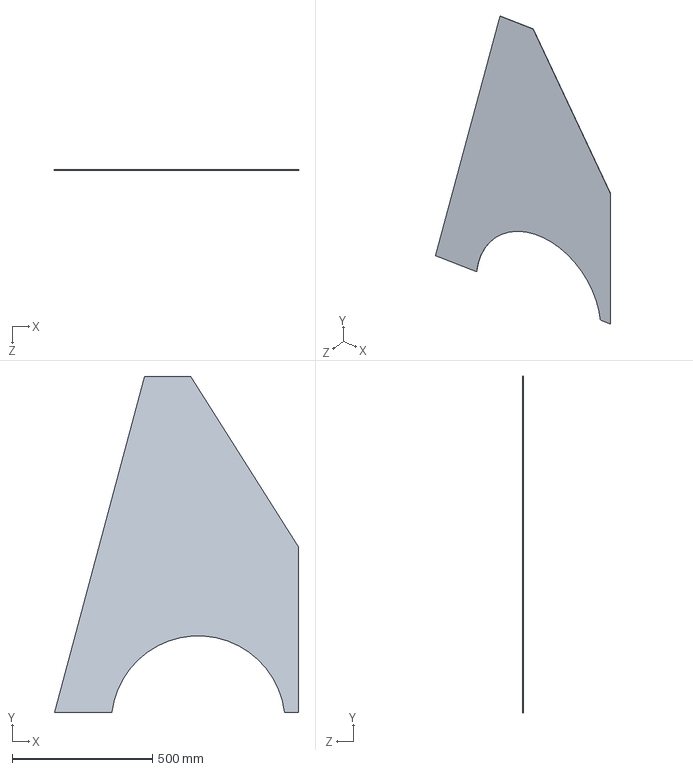
[picture p131: CAD file, 2024-04-30]
main assembly/chassis/rear body above wheels.SLDPRT
871.3 x 1199.7 x 1.50 mm
