ayushgupta9906/Effi-QUI-ADAS-Four-Wheel-Fully-Electric-Vehicle---TGW-ZHCET/main assembly/headlight.SLDPRT

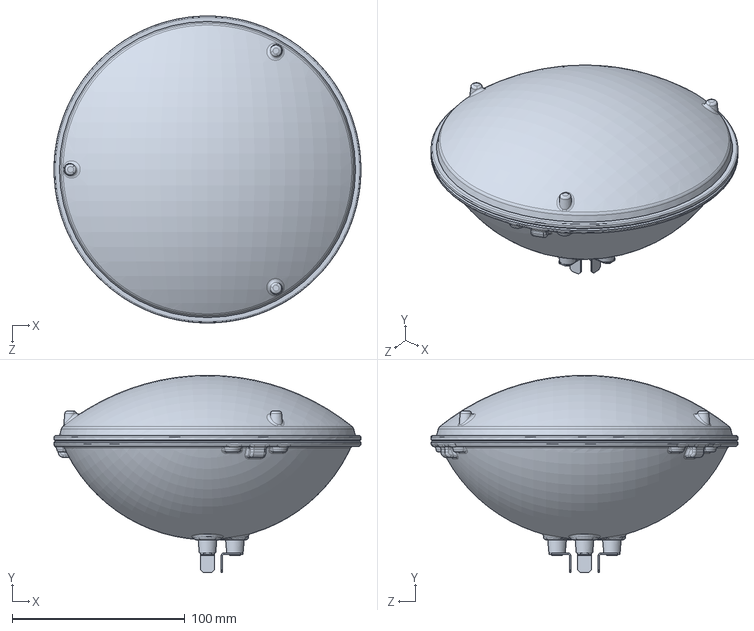
[picture p132: CAD file, 2024-04-30]
main assembly/headlight.SLDPRT
177.8 x 114.3 x 177.8 mm
