ayushgupta9906/Effi-QUI-ADAS-Four-Wheel-Fully-Electric-Vehicle---TGW-ZHCET/main assembly/seat/seat bum.SLDPRT

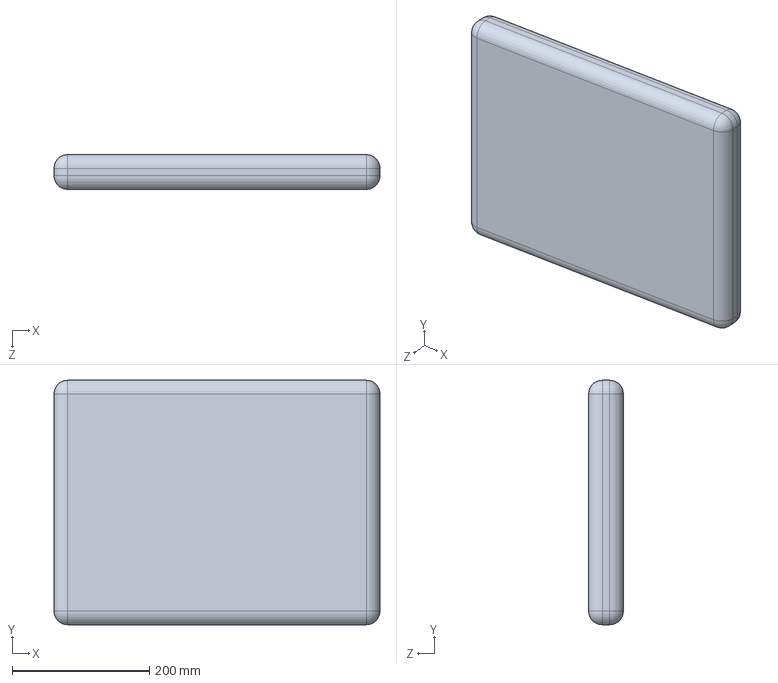
[picture p133: CAD file, 2024-04-30]
main assembly/seat/seat bum.SLDPRT
475.0 x 356.3 x 50.8 mm
