ayushgupta9906/Effi-QUI-ADAS-Four-Wheel-Fully-Electric-Vehicle---TGW-ZHCET/main assembly/suspension and wheels/tyre.SLDPRT

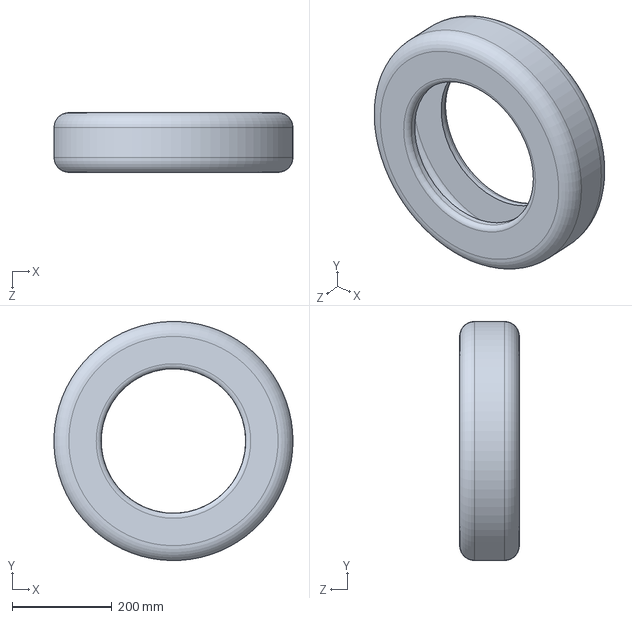
[picture p134: CAD file, 2024-04-30]
main assembly/suspension and wheels/tyre.SLDPRT
479.8 x 479.9 x 120.0 mm
