ayushgupta9906/Effi-QUI-ADAS-Four-Wheel-Fully-Electric-Vehicle---TGW-ZHCET/main assembly/utility box/Part2 door.SLDPRT

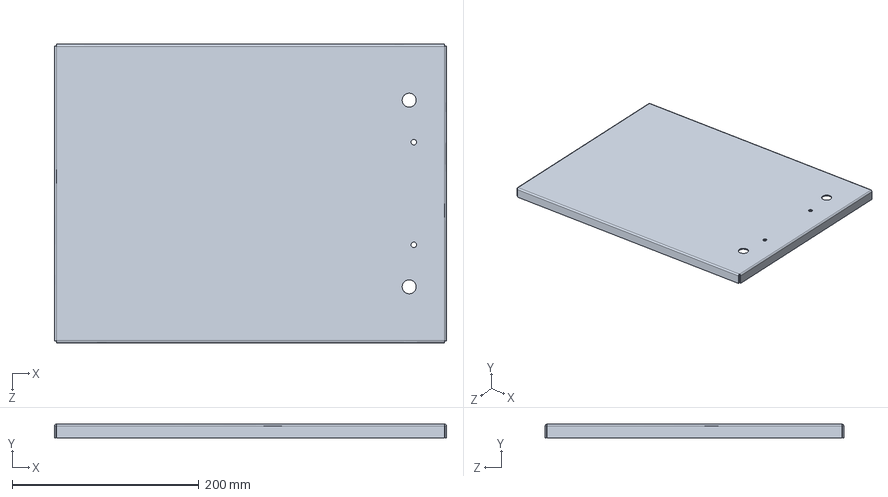
[picture p135: CAD file, 2024-04-30]
main assembly/utility box/Part2 door.SLDPRT
420.0 x 15.0 x 320.0 mm
