ayushgupta9906/Effi-QUI-ADAS-Four-Wheel-Fully-Electric-Vehicle---TGW-ZHCET/main assembly/body works/body works front.SLDPRT

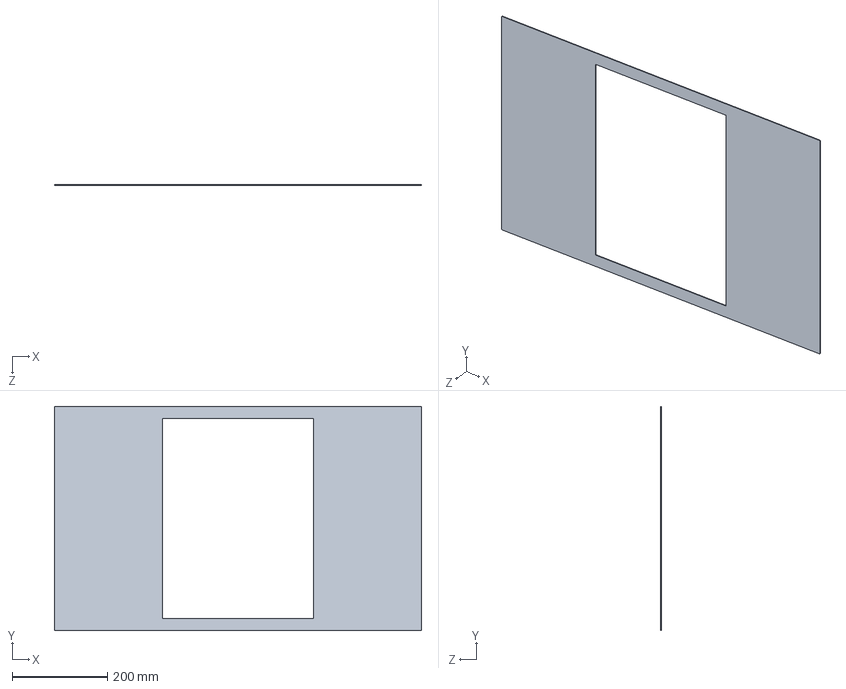
[picture p136: CAD file, 2024-04-30]
main assembly/body works/body works front.SLDPRT
770.0 x 470.0 x 1.50 mm
