ayushgupta9906/Effi-QUI-ADAS-Four-Wheel-Fully-Electric-Vehicle---TGW-ZHCET/main assembly/chassis/final chassis.SLDPRT

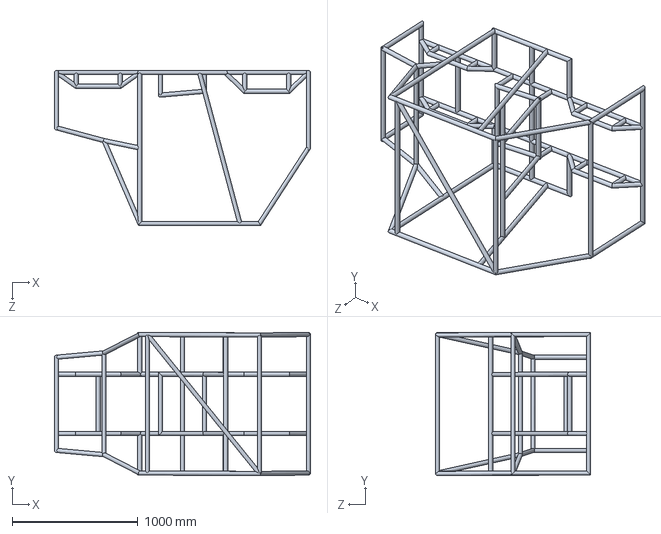
[picture p137: CAD file, 2024-04-30]
main assembly/chassis/final chassis.SLDPRT
2033.4 x 1136.8 x 1233.4 mm
