ayushgupta9906/Effi-QUI-ADAS-Four-Wheel-Fully-Electric-Vehicle---TGW-ZHCET/main assembly/LED headlight.SLDPRT

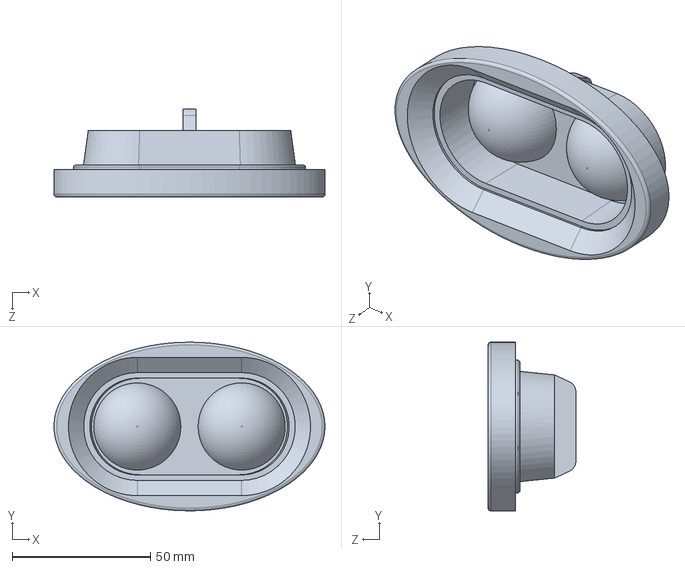
[picture p138: CAD file, 2024-04-30]
main assembly/LED headlight.SLDPRT
98.0 x 61.0 x 31.8 mm
