ayushgupta9906/Effi-QUI-ADAS-Four-Wheel-Fully-Electric-Vehicle---TGW-ZHCET/main assembly/powertrain/shaft and differential.SLDPRT

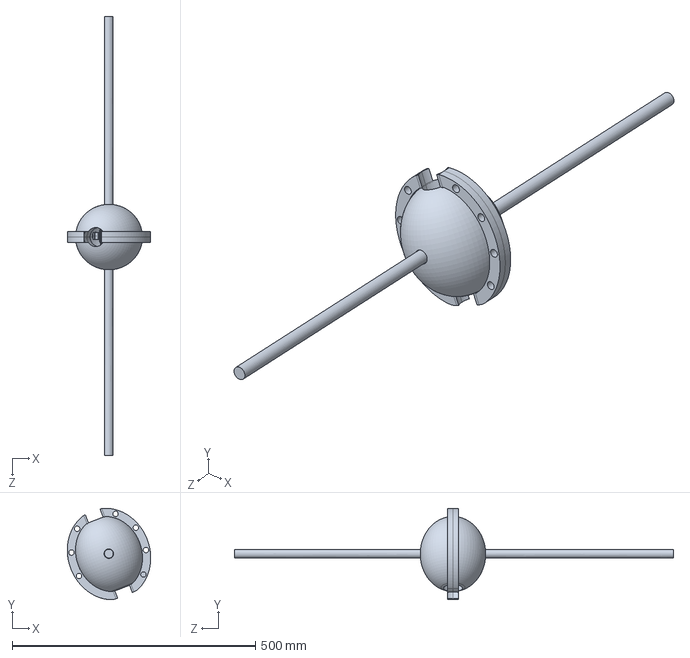
[picture p139: CAD file, 2024-04-30]
main assembly/powertrain/shaft and differential.SLDPRT
171.4 x 187.8 x 902.0 mm
