ayushgupta9906/Effi-QUI-ADAS-Four-Wheel-Fully-Electric-Vehicle---TGW-ZHCET/main assembly/seat/Seat base metal .SLDPRT

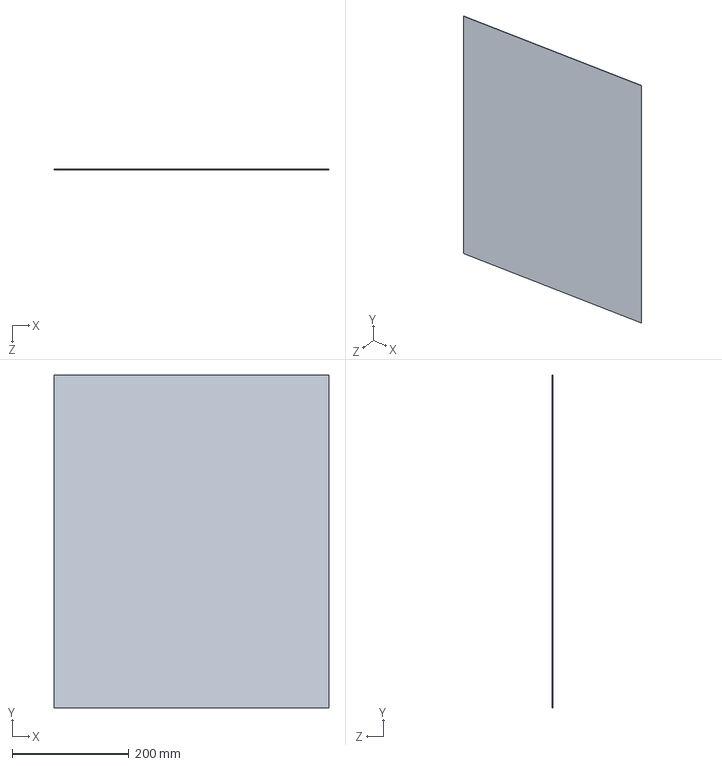
[picture p140: CAD file, 2024-04-30]
main assembly/seat/Seat base metal .SLDPRT
470.0 x 570.0 x 1.00 mm
