ayushgupta9906/Effi-QUI-ADAS-Four-Wheel-Fully-Electric-Vehicle---TGW-ZHCET/main assembly/steering/steering design/cross1.SLDPRT

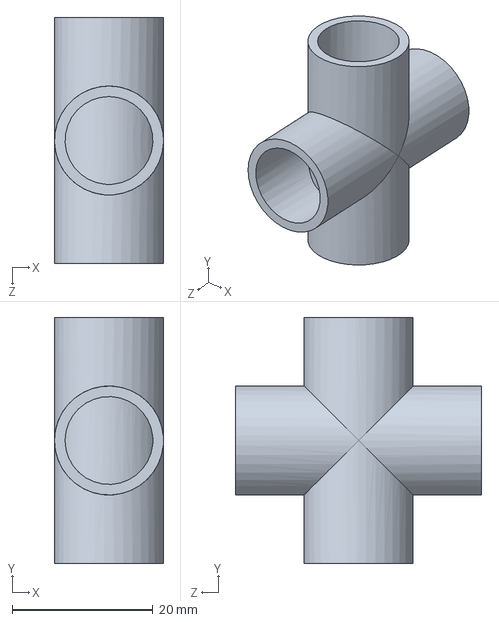
[picture p141: CAD file, 2024-04-30]
main assembly/steering/steering design/cross1.SLDPRT
15.5 x 35.0 x 35.0 mm
