ayushgupta9906/Effi-QUI-ADAS-Four-Wheel-Fully-Electric-Vehicle---TGW-ZHCET/main assembly/suspension and wheels/Wheel Hub .SLDPRT

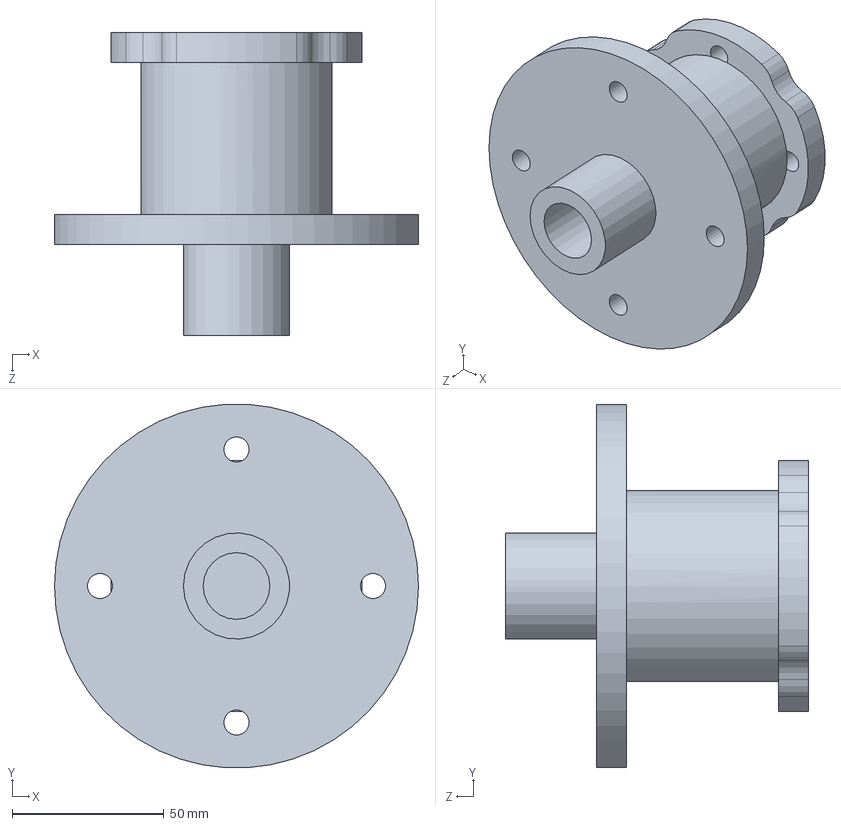
[picture p142: CAD file, 2024-04-30]
main assembly/suspension and wheels/Wheel Hub .SLDPRT
120.0 x 119.8 x 100.0 mm
