ayushgupta9906/Effi-QUI-ADAS-Four-Wheel-Fully-Electric-Vehicle---TGW-ZHCET/main assembly/utility box/Part3 handle.SLDPRT

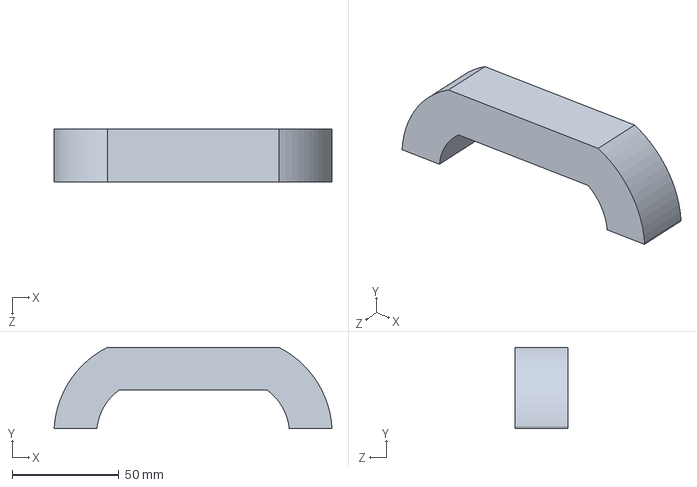
[picture p143: CAD file, 2024-04-30]
main assembly/utility box/Part3 handle.SLDPRT
130.0 x 38.0 x 25.0 mm
