ayushgupta9906/Effi-QUI-ADAS-Four-Wheel-Fully-Electric-Vehicle---TGW-ZHCET/main assembly/body works/Front fairing.SLDPRT

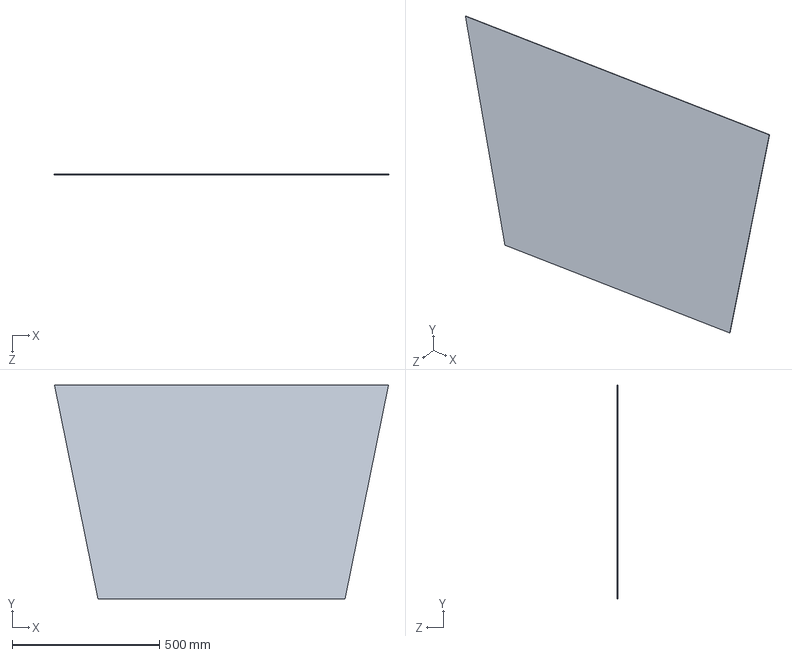
[picture p144: CAD file, 2024-04-30]
main assembly/body works/Front fairing.SLDPRT
1134.3 x 725.2 x 1.50 mm
