ayushgupta9906/Effi-QUI-ADAS-Four-Wheel-Fully-Electric-Vehicle---TGW-ZHCET/main assembly/steering/steering design/rod.SLDPRT

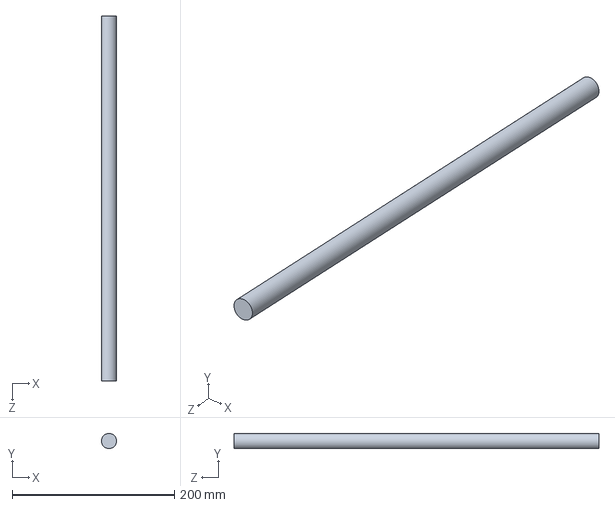
[picture p145: CAD file, 2024-04-30]
main assembly/steering/steering design/rod.SLDPRT
18.7 x 18.7 x 450.0 mm
