ayushgupta9906/Effi-QUI-ADAS-Four-Wheel-Fully-Electric-Vehicle---TGW-ZHCET/main assembly/body works/Back body with fairing.SLDPRT

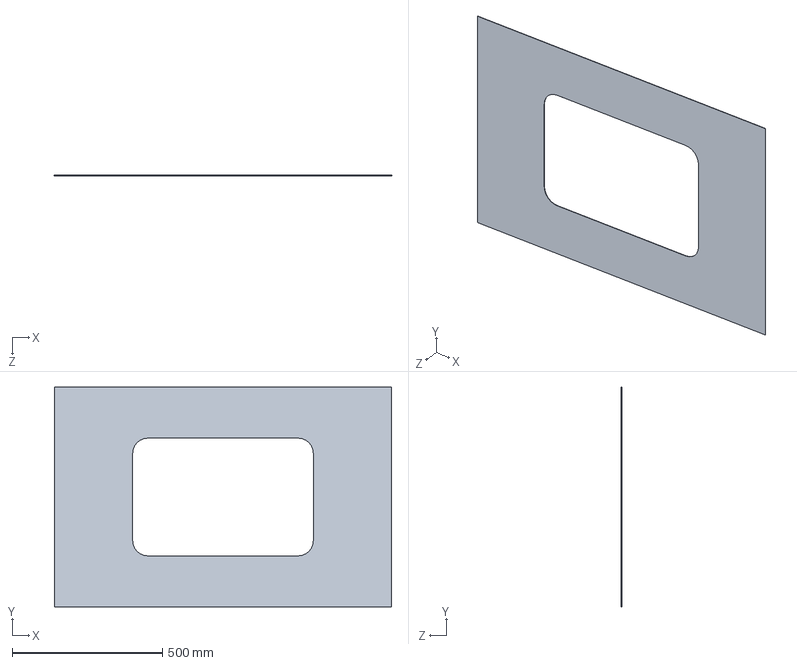
[picture p146: CAD file, 2024-04-30]
main assembly/body works/Back body with fairing.SLDPRT
1120.0 x 730.0 x 1.50 mm
