ayushgupta9906/Effi-QUI-ADAS-Four-Wheel-Fully-Electric-Vehicle---TGW-ZHCET/main assembly/chassis/Towing point.SLDPRT

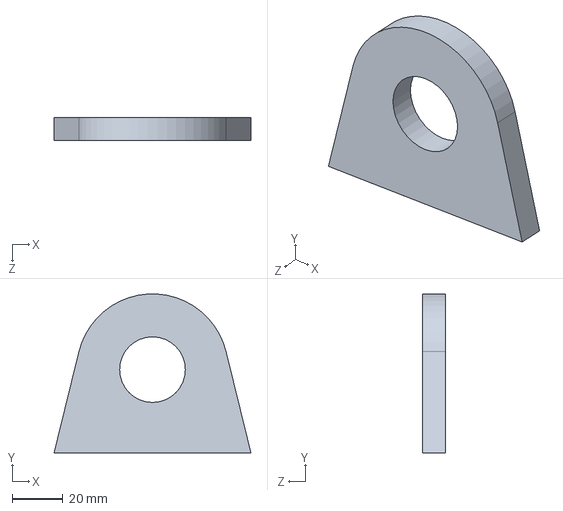
[picture p147: CAD file, 2024-04-30]
main assembly/chassis/Towing point.SLDPRT
78.0 x 62.9 x 9.00 mm
