ayushgupta9906/Effi-QUI-ADAS-Four-Wheel-Fully-Electric-Vehicle---TGW-ZHCET/main assembly/steering/steering design/hooke's joint.SLDPRT

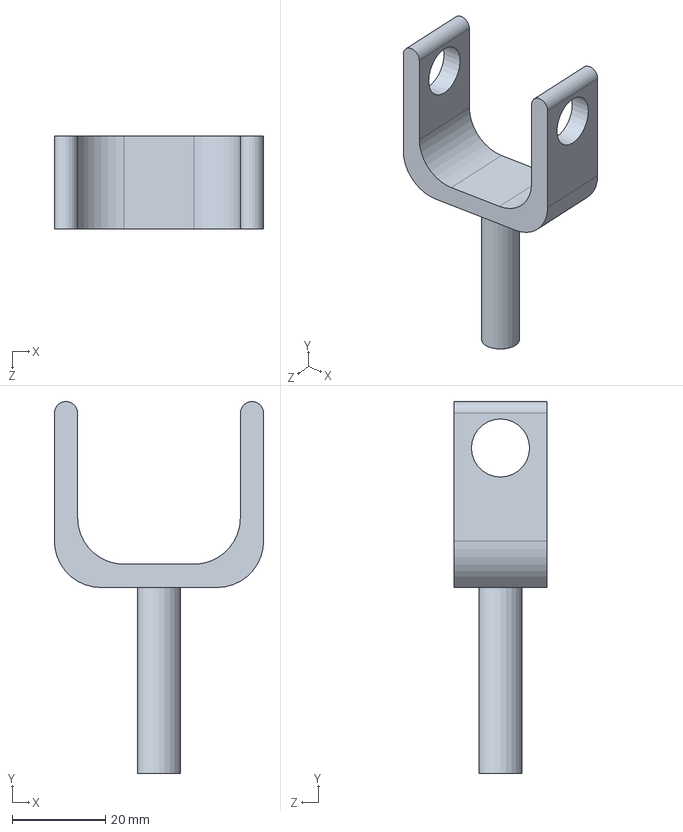
[picture p148: CAD file, 2024-04-30]
main assembly/steering/steering design/hooke's joint.SLDPRT
45.0 x 80.0 x 20.0 mm
