ayushgupta9906/Effi-QUI-ADAS-Four-Wheel-Fully-Electric-Vehicle---TGW-ZHCET/main assembly/suspension and wheels/A Arms/heim joint.SLDPRT

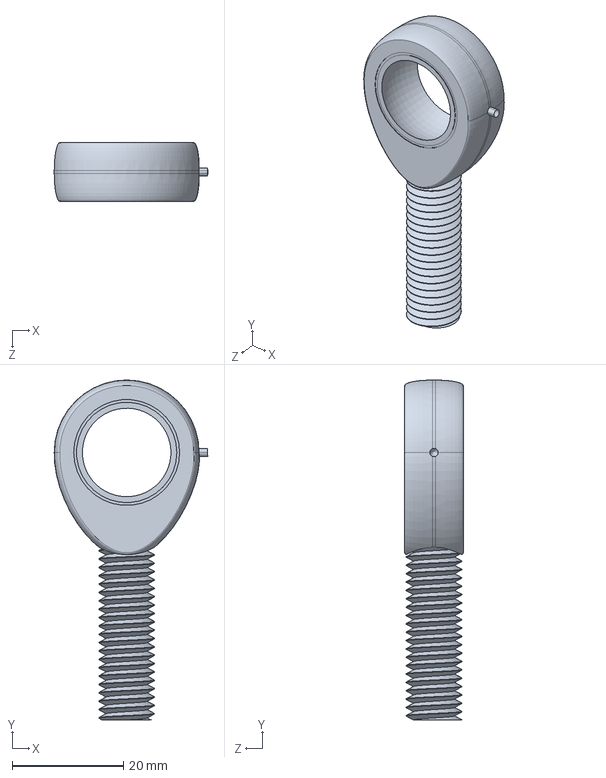
[picture p149: CAD file, 2024-04-30]
main assembly/suspension and wheels/A Arms/heim joint.SLDPRT
27.6 x 61.0 x 10.5 mm
