ayushgupta9906/Effi-QUI-ADAS-Four-Wheel-Fully-Electric-Vehicle---TGW-ZHCET/main assembly/body works/Back fairing.SLDPRT

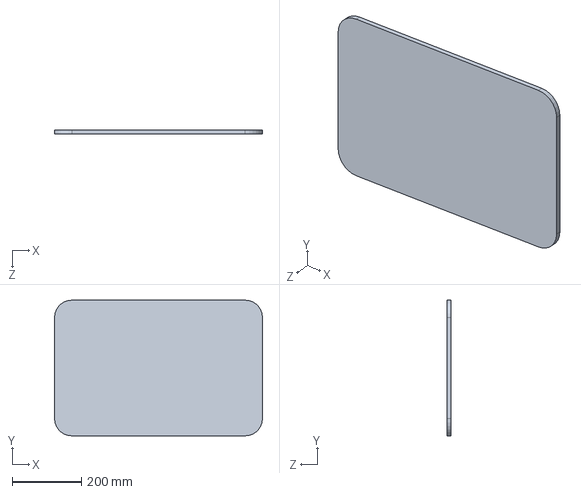
[picture p150: CAD file, 2024-04-30]
main assembly/body works/Back fairing.SLDPRT
600.0 x 391.3 x 11.5 mm
