ayushgupta9906/Effi-QUI-ADAS-Four-Wheel-Fully-Electric-Vehicle---TGW-ZHCET/main assembly/chassis/Front wheel body works.SLDPRT

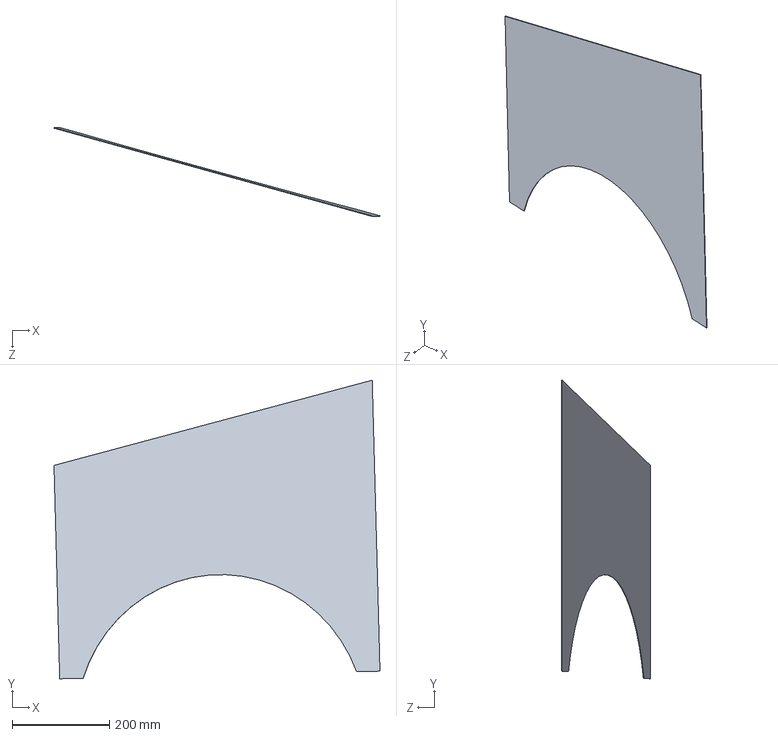
[picture p151: CAD file, 2024-04-30]
main assembly/chassis/Front wheel body works.SLDPRT
671.9 x 615.5 x 183.4 mm
