ayushgupta9906/Effi-QUI-ADAS-Four-Wheel-Fully-Electric-Vehicle---TGW-ZHCET/main assembly/body works/Back body works.SLDPRT

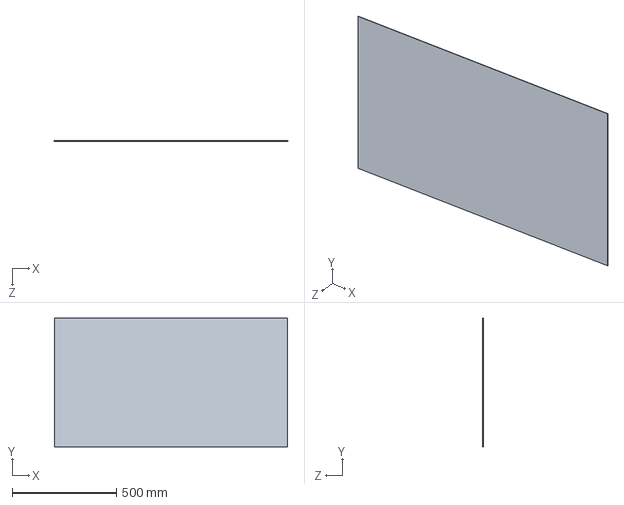
[picture p152: CAD file, 2024-04-30]
main assembly/body works/Back body works.SLDPRT
1120.0 x 620.0 x 1.50 mm
