ayushgupta9906/Effi-QUI-ADAS-Four-Wheel-Fully-Electric-Vehicle---TGW-ZHCET/main assembly/steering/steering design/steering wheel.SLDPRT

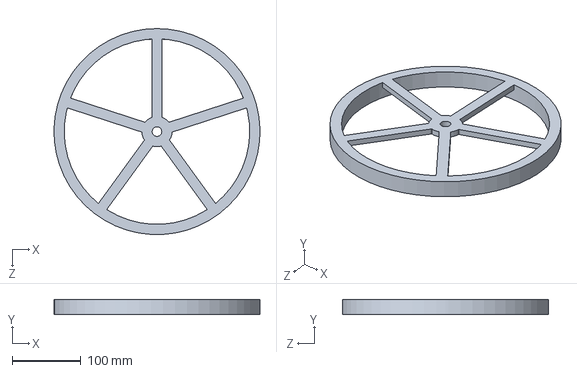
[picture p153: CAD file, 2024-04-30]
main assembly/steering/steering design/steering wheel.SLDPRT
299.9 x 22.5 x 299.7 mm
