ayushgupta9906/Effi-QUI-ADAS-Four-Wheel-Fully-Electric-Vehicle---TGW-ZHCET/(list of files, cad)

Other CAD files:
main assembly/suspension and wheels/A Arms/right upper A Arm Assembly.SLDPRT
main assembly/suspension and wheels/A Arms/left lower A Arm Assembly.SLDPRT
main assembly/powertrain/chain-and-sprocket.snapshot.4/Renderings/Chain IGS/26 Tooth .5 Pitch Sprocket .IGS
main assembly/powertrain/Motor/600W Motor 48V.SLDPRT
main assembly/steering/steering design/steering geometry sketch.SLDPRT
main assembly/geometry.SLDPRT
main assembly/powertrain/Motor/motor.SLDPRT
main assembly/knuckle/Rear Knuckle right.SLDPRT
main assembly/powertrain/Motor/2nd Sprocket.SLDPRT
main assembly/chassis/right door.SLDPRT
main assembly/brakes/brake assembly.SLDPRT
main assembly/powertrain/shaft_and_differential.SLDPRT
