ayushgupta9906/Effi-QUI-ADAS-Four-Wheel-Fully-Electric-Vehicle---TGW-ZHCET/main assembly/powertrain/chain-and-sprocket.snapshot.4/Chain and Sprocket/Chain and Sprockets.jpg

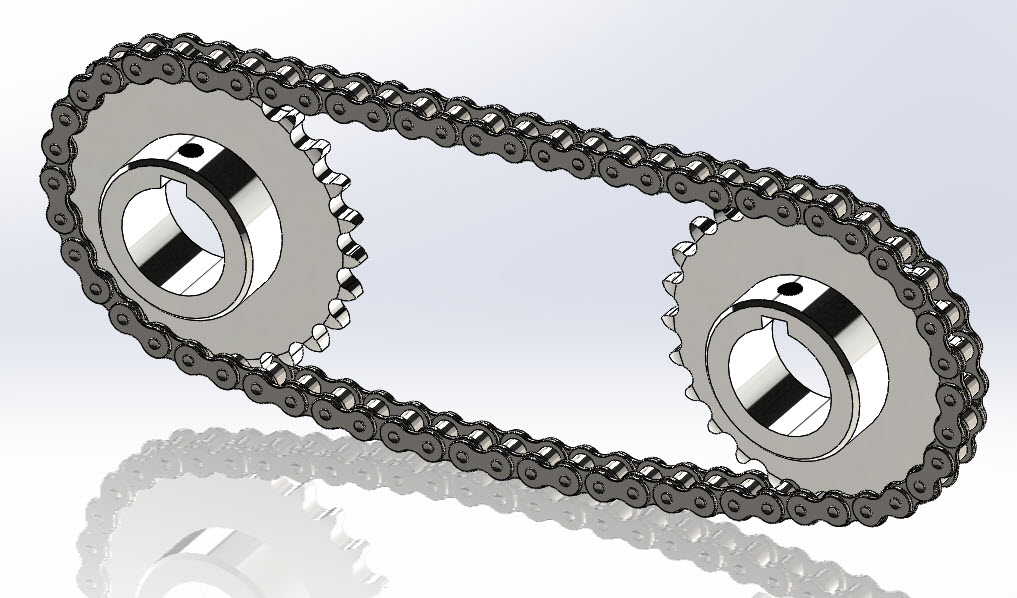
main assembly/powertrain/chain-and-sprocket.snapshot.4/Chain and Sprocket/Chain and Sprockets.jpg
