ayushgupta9906/Effi-QUI-ADAS-Four-Wheel-Fully-Electric-Vehicle---TGW-ZHCET/main assembly/powertrain/chain-and-sprocket.snapshot.4/Renderings/untitled.112.jpg

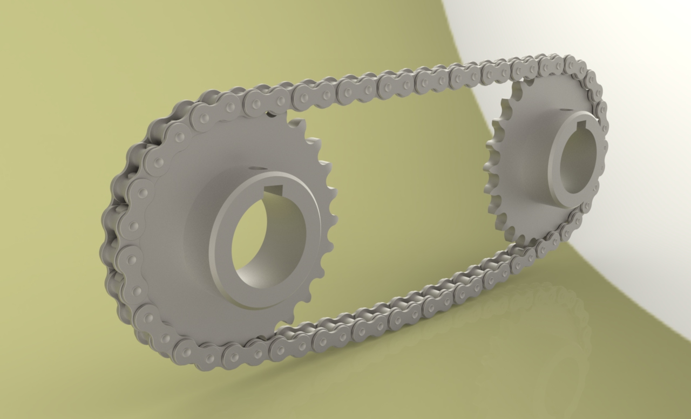
main assembly/powertrain/chain-and-sprocket.snapshot.4/Renderings/untitled.112.jpg
