ayushgupta9906/Effi-QUI-ADAS-Four-Wheel-Fully-Electric-Vehicle---TGW-ZHCET/main assembly/powertrain/Motor/1.JPG

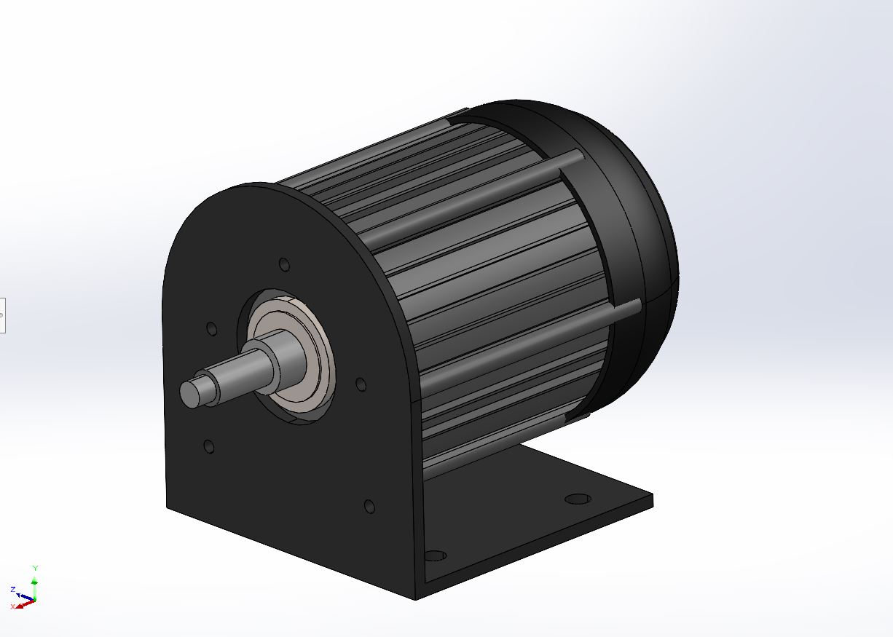
main assembly/powertrain/Motor/1.JPG
