ayushgupta9906/Effi-QUI-ADAS-Four-Wheel-Fully-Electric-Vehicle---TGW-ZHCET/main assembly/solar-panel-30.snapshot.2/solar_panel_2017-Apr-25_01-04-46PM-000_HOME_png_alpha.png

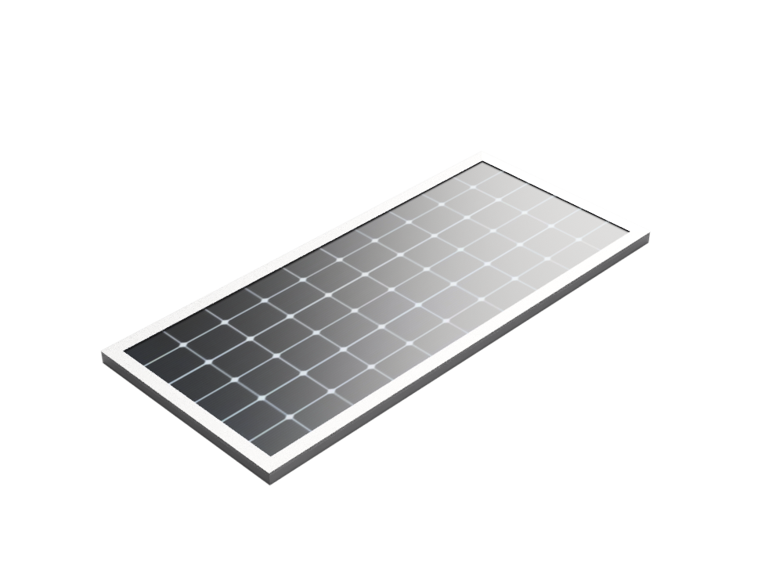
main assembly/solar-panel-30.snapshot.2/solar_panel_2017-Apr-25_01-04-46PM-000_HOME_png_alpha.png
