ayushgupta9906/Effi-QUI-ADAS-Four-Wheel-Fully-Electric-Vehicle---TGW-ZHCET/main assembly/solar-panel-30.snapshot.2/solar_panel_2018-May-25_11-41-44AM-000_CustomizedView25951266668_png.png

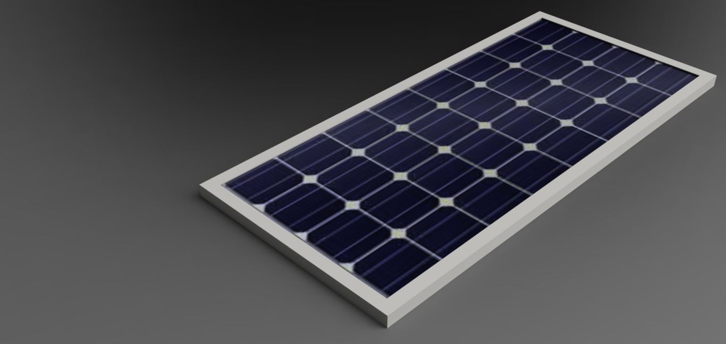
main assembly/solar-panel-30.snapshot.2/solar_panel_2018-May-25_11-41-44AM-000_CustomizedView25951266668_png.png
