ayushgupta9906/Effi-QUI-ADAS-Four-Wheel-Fully-Electric-Vehicle---TGW-ZHCET/23056_Green Warriors_Document Package (1)/23056_Green Warriors_Document Package/23056_Green Warriors_DVP&DFMEA.xlsx

Sheet: DVP
Efficycle 2023 Design Validation Plan
Team ID |  |  | Team Name |  |  |  |  | Target Vehicle Completion Date
23056 |  |  | GREEN WARRIORS |  |  |  |  | 2023-11-30
Sr. No. | Subsystem | Part/Parameter Under Validation | Responsible Person | Design/Performance Requirement | Validation Method | Equipment/ Instrument used | No. of Trials/ Fequency | Validation Test Observations | Result | Remarks
1 | Battery | Charging Time | Ayush Gupta | Discharged battery should fully charge in 2 hrs | Check Terminal Voltage before charging and after 2hrs | Multimeter, stopwatch | min 10 trials | 1. V1= …47.2..V, V2…47.=V | battery capacity was well | V1= Voltage before plug-in V2= Voltage after 2hrs
 |  |  | Munazir |  | If terminal voltage is<47V in 2hrs, check voltage at every 15mins and note time at 12V | Multimeter, stopwatch | min 10 trials | charging was taking some more time | battery was fully charged in 2. 6 hours | A crucial metric assessing speed and efficiency in battery replenishment.
 |  | Leakage check | Abdus Samad | No leakage from battery in static & dynamic conditions | Tilt battery on all 4 sides by not more than 45deg, hold for 10 sec and observe any leakage | Stopwatch | Min 3 trials | Battery was not leaking | no harm from the battery | Do not touch bare hand and use safety precautions, gloves, goggles, shoes, metal trays etc
 |  |  | Farhan Abid |  | Check battery each time when vehicle runs >1km | N/A | Min 3 trials | no leakage | battery was heated a bit | Don’t touch battery, take photos etc
 |  | Battery voltage test | Ayush Gupta | Primary battery should produce desired voltage | Check emf at random intervals while test run. | Multimeter | min 10 trials | battery was giving 46 volts as output |  | Temperature and discharge of the battery should be checked regularly
 |  |  | Ayush Gupta | Secondary battery should produce desired voltage | Check emf at random intervals while test run. | Multimeter | min 10 trials | battery was giving 8.5 volts as output |  | Carefully connect the terminals of the battery to terminals of other component
2 | Body Enclosures | Enclosure | Farhan Abid | Enclosures should not deform and detach from the frame | Check enclosures after vehicle running | Test track, Torque Wrench | every 2km | enclosures were properly attached to frame | A little noise can be observed from them | It ensuring protection and integrity of internal components.
 |  | Fairing | Mohd Munazir Mairaj | Bear projectile penetration | Visual Inspection | Collision of a foreign object | min 3 Trials | Fairing was tight enough and easily bearing air pressure |  | Maintain safe distance while projecting
3 | Dimension | Length | Farhan Abid | Length= 2040mm | Check length b/w front & rear projected parts | measuring tape | One time | length was within the range
 |  | Width |  | Width= 1115mm | Check width b/w front & rear projected parts | measuring tape | One time | width was within the range
 |  | Seat Height | Mohd Munazir Mairaj | Seat Height at Point A=432mm | Check height | Scale/ measuring tape | One time | seat height was below 20 inches from groung
 |  | Sitting Space Height |  | Sitting Space height=1174mm | Use calibrated measurement tools to ensure accurate height readings. | Scale/ measuring tape, spirit level | One time | enough space for the driver
 |  | Seat Inclination |  | Seatback angle=15deg | …….. | Inclinometer | One time | proving proper comfort to the driver | driver can easily drive for hours without getting tired
4 | Drive Train | Chain | Ayush Gupta | No mechanical failure and breakage | Quality Check, run the vehicle both on manual as well as electric power train | Test Track | min.15 trials | Perform a quality check by running the vehicle on both manual and electric power trains. |  | Chain should neither be too tight nor too loose.
 |  | Shaft | Ayush Gupta | Proper delivery of torque from the transmission to wheels without any bending, breakage and structural failure. | Quality Check, run the vehicle both on manual as well as electric power train | Test Track | min.15 trials | Sprockets are slipping from shaft | Drilling small holes on shaft in order to stop sprockets from slipping. | There shouldn't be any bending, breakage and structural failure.
 |  | Shaft twist | Ayush Gupta | Shaft must not fracture even at max torque conditions | Repeated extreme acceleration of driveshaft | N/A | min.15 trials | The shaft successfully withstood maximum torque conditions without fracturing during testing. |  | Influencing performance and precision, defining dynamic characteristics for an enhanced user experience.
 |  | Load Test | Ayush Gupta | To verify that the motor produces torque corresponding to the nameplate parameters at no load | By lifting vehicle mechanically in air and running motor at max power and measure all parameters. | Torque Gauge,tachometer, Multimeter | min.15 trials | Ensure the motor generates torque in accordance with the nameplate specifications during no-load operation. |  | Load test is to measure speed, efficiency, power factor, stator current, torque and slip of an induction motor and how it vary with load
 |  |  | Ayush Gupta | To verify that the motor produces torque corresponding to the nameplate parameters at full load | By Loading vehicle with max load and running motor at max power and measure all parameters. | Torque Gauge,tachometer, Multimeter | min 15 trials | Load the vehicle with the heaviest weight it can carry, run the motor at its strongest, and measure all the important factors.
 |  | Differential | Ayush Gupta | Validate the functionality and performance of the differential under specified conditions, ensuring proper torque distribution and smooth operation. | Conduct a series of tests and inspections to verify the differential's design and performance against established criteri | Torque Wrench,Vibration Analyzer Visual Inspection Tools | min 15 trials | Torque Wrench Testing: Validate torque settings for different conditions. | Each test category should meet or exceed specified design and performance criteria. | Key to performance, defining dynamics for an optimized experience.
5 | Braking System | Stopping Distance | Abdus Samad Suhail | Stopping Distance=3.6m (<5m as per rulebook criteria) @25km/h | Attain speed 25kmph within 50 m, stop before 5m | Measuring Tape, Stop Watch, Brake Test Track to be made as per rulebook | min 15 trials | Stopping Distance Trial 1= …6…..m Trial 2=……5...m .. 4.8 m ..4.5 m | Max stopping distance= 3.5m | Crucial metric defining braking performance for a safer driving experience.
 |  |  | Abdus Samad Suhail | Stopping Distance <6m @ max speed = 30 km/h (only if top speed >25km/h) | Attain speed 30 kmph within 50 meters, stop before 6m | N.A. | min 15 trials
 |  | Brake Light | Abdus Samad Suhail | Should Glow during braking | Visual observation whenever brakes are applied | Try Square, Scale, measuring tape | 3 times |  |  | Brake lights should be bright enough to be visible in sunlight from 30m.
 |  | Brake Force Distribution (Brake pedal, Master Cylinder, Brake Wire) | Abdus Samad Suhail | All brakes must work at same time and vehicle should go straight during braking | Perpendicular Lines marked on track, Deviation on LH/RH <300mm | N.A. | min 15 trials | Offset from Straight Line Trial 1= ……..m Trial 2=……...m |  | Critical system encompassing brake pedal, master cylinder, and brake wire for precise control and enhanced safety
 |  |  | Abdus Samad Suhail |  | Visual observation to check vehicle skidding | N.A. | min 15 trials | Visually observe the vehicle's tire interaction with the road surface to check for any signs of skidding.
 |  | Brake caliper | Abdus Samad Suhail | Caliper Mount should not fail | Sharp Breaking at 25 kmph | N.A. | min 15 trials | Execute sharp braking at a speed of 25 km/h.
 |  | Brake cable | Abdus Samad Suhail | Should not snap during breaking | Repeated Extreme Braking | N.A. | min 15 trials | Conduct repeated extreme braking maneuvers. |  | Critical component ensuring precise braking for enhanced safety and performance
 |  | Cable routing | Abdus Samad Suhail | Ergonomically Routed | Visual Inspection | N.A. | 3 times |  |  | Hinderance in any form to occupants is unwanted
6 | Electrical Components | Electrical Failure | Mohd Munazir Mairaj | All circuits should perform their desired task and should be provided proper insulation | Check the connections each time when vehicle runs >1km | Multimeter | Min. 5 trials | No failure | electrical components are working fine | It issue impacting performance and reliability in electronic systems
 |  | Kill Switch | Abdus Samad Suhail | Should turn off all the circuits during emergency situation | Simulating emergency situation | Multimeter | Min. 5 trials | vehicle and all circuits stops | kill switch is working fine | Essential component for immediate system shutdown
 |  | Temperature of Circuits | Ayush Gupta | Max temperature of circuit boards and wires should remain below manufacturer recommended temp. | Testing all electronic systems for straight 15 mins and checking temp. | Thermal Camera | Min 3 Trials | temperature observed is between 40'C to 50'C | no overheating is observed | Key for electronic system performance and reliability
 |  | Wire Connections | Iftekhar Alam | All Wire Connections should be tight | Visual Inspection | N/A | 5 times | wires does not disconnect or connections do not loose | wires are soldered and connected tightly | Vital for system reliability and optimal performance.
 |  | Solar Panel | Mohd Munazir Mairaj | Should have efficiency about 40% at max intensity sunlight | Lab Testing of solar panel used In Lab | In Lab under Standard Test Condition | min 10 Trials | charing properly at max intensity | Solar panle is able to charge battery | Key for sustainable and efficient power generation.
 |  | IP65 Battery Enclosure Protection | Sejal Ahmad | Able to protect against water jets | Water projected by a nozzle (6.3mm) against enclosure from any direction for 5 Mins | Water cannon(30kPa) from 3 m distance at rate of 12.5 lts per min | Min. 5 trials | No water is able to reach battery | battery is well protected | Robust protection, ensuring reliability in diverse conditions
7 | Electronic Systems | ADAS(Advanced Driver Assistant System) | Ayush Gupta | All circuits should perform their desired task and should be provided proper insulation | Visual inspection and values checked on serial monitor | N/A | min 3 Trials | Correct values on serial monitor | System are working fine and giving desired output | Connections should be one properly
 |  | Energy Regeneration | Abdus Samad Suhail | Battery must be charging by regeneration systems . | Charging of battery is checked | N/A | min 3 Trials | battery is charging | System are working fine and giving desired output | Reverse charging should not happen
 |  | Infotainment System | Abdus Samad Suhail | Should be able to listen to music and display video output on the screen | Visual inspection and values checked on serial monitor | N/A | min 3 Trials | all are working as required | Components are working fine and giving desired output | Sound of speeakers should not distract others or driver
 |  | Tuning | Ayush Gupta | Reading by Odometer and Speedometer should be approximately equal to ideal measurements | Running vehicle on a test track and comparing results with emperical and calculated data. | Surveyor's Wheel, Stopwatch | min 15 Trials | odometer reading= 100m actual reading= 100m speedometer = 10km/hr actual speed = 10km/hr | working correctly | Should not be much diffrence betweem actual and reading by odometer
8 | Fasteners | Grip | Mohd Munazir Mairaj | Fasteners should not get loose during running | Check fasteners after vehicle running | Torque Wrench | every 2km | The fasteners did not got loosed | They were tight enough | It signifies control, resilience, and proficiency.
 |  | Material | Farhan Abid | All bolts and fasterners comply with Grade 8.8 standard | ….. | N/A | ….. |  |  | Grade 8.8 fasteners are made of mild steel and possess high tensile strength
9 | Frame | Weld Quality | Farhan Abid | No Cracks should be present at the frame members & weld joints | Visual check of all frame members & joints (One Time) | Hammering | min 10 trials | Most of the welds were good, only few were weak | welded all the parts properly | It ensures structural integrity
 |  | Mount Durability | Munazir, Farhan | Required weld length on mounts as per rulebook | Visual Inspection of all mounts | Measuring Tape | min 10 trials | mounts were durable enough |  | Is crucial for sustained performance
 |  | Hard point Analysis | Munazir, Farhan | Hard points should bear internal and external loads without deforming | CAE and Calculation | CAE | min 10 trials | hard points were capable to bear load without showing much deformation |  | Extreme conditions to be taken for analysis of all hard point.s
 |  | Bottom Brackets and loads | Munazir, Farhan | Should bear Axial loads, Bending, Torsion | Running vehicle at max speed in pedals configuration | N/A | min 10 trials | were bearing load properly |  | It handle diverse loads effectively,
 |  | Utility Box | Munazir, Farhan | Should bear impacts without damage | Running vehicle over speed breakers and potholes | Test Track | min 15 | It was capable to bear 20kg in the test track | posesses good strength | It enhances functionality
 |  | Driver Clearance | Munazir, Farhan | All clearance should be followed as per rulebook | Visual Inspection | Measuring Tape | 3 times |  |  | optimal design, ensuring sufficient space and efficiency.
 |  | Mock Endurance | Munazir, Farhan | Overall stability of all welds and joints | Drive the vehicle for 1 hours continuously and check for possible failure | Test Track | min 3 Times |  |  | Vital for durability testing and reliability in simulations.
10 | Steering | Turning Radius | Abdus Samad Suhail | Turning Radius < 4m | Performance testing by "Figure of 8" test. | Measuring Tape, Stop Watch, 'Figure of 8' track to be made as per rulebook | Min. 10 | First we have achieved turning radius of 3.9m then a new steering arm is designed that gives the turning radius of 2.8m | Steering plate is bending | Vehicle must make turn within 2 m and 4 m circle bounds.
 |  | Strength and Force Transmission | Abdus Samad Suhail | The steering column should not break while transferring the force to the wheels | Performance testing by running vehicle on roads with turns | Test Track | min. 15 trials |  |  | Are critical for performance
 |  | Safe Turning without skid | Abdus Samad Suhail | Should turn safely at speed 16 kmph | Calculation (assumed friction coeff= 0.7 and turning radius 2.8m) | Calculations | ..... | Vehicle was turning prperly | We did our best to maximize it's turn | Formula used=(μrg)^1/2
 |  | Tie Rods | Abdus Samad Suhail | Mechanically Strong to bear Strain and Stresses | Rough Terrain | Rought Track | min 15 Trials |  |  | Ensure stability
 |  | Alignment | Abdus Samad Suhail | Alignment should remain even after a rough ride | Running vehicle on roads with turns and bumps | Tape Measure, alighnment shims,wrench | min 10 trials | The alignment of the components was proper | we took necessary actions to make it aligned | Undergo rigorous configuration testing
 |  | Steering Angle and config test | Abdus Samad Suhail | Steering Mechanism should follow Ackerman Geometry | Theoretical | SolidWorks | N/A |  |  | Undergo rigorous configuration testing
11 | Seating | Clearance | Munazir, Farhan | All clearances to driver must be satisfied | Visual Inspection | Measuring Tape | min 3 Times | All the clearances were satisfied |  | Ensuring optimal space and functionality.
 |  | Load Analysis | Munazir, Farhan | Seat Member should bear maximum possible bending stress | CAE and Visual Inspection | Ansys | min 3 Trials | Members were capable to bear 100 kg or more | It has good strength | Inspection to be done with heaviest team member as driver
 |  | Seat Belt | Munazir, Farhan | Use of 3-point seat belts in accordance with guidelines in rulebook | Sudden Braking after running vehicle at top speed | Test Track | min 10 Trials | Perform sudden braking after running the vehicle at its top speed. |  | Helmets and other safety equipment should be utilized for tester's safety
12 | Suspension | Front suspension geometry | Sejal Ahmad | The roll centre should not shift a lot and the wheels should not gain excessive camber when encountering a bump | Using suspension analysis software to simulate real track conditions | Simulation software | min 10 trials | Utilize suspension analysis software for simulating actual track conditions. |  | Responsive stability through advanced geometry.
 |  | Springs | Mohd Iftikhar Alam | Maintains the suspension system at a predetermined height and support added weight without excessive sagging. | Check conditions visually after performance testing on roads with bumps | Test Track | min. 15 trials | Visually inspect the vehicle's condition after conducting performance tests on roads with bumps. |  | There shouldn't be spring fractures.
 |  | Damper | Mohd Iftikhar Alam | Should withstand stresses and no fluid should be leaked. | Check conditions visually after performance testing on roads with bumps | Test Track | min. 15 trials |  |  | Dynamic control for optimal ride comfort
 |  | Load Distribution | Mohd Iftikhar Alam | Suspension system should be capable to bear load at extreme cornering conditions | Observing the behaviour of Shock absorber in extreme conditions | Test Track | min. 10 trails | suspension system was capable to bear load | load was properly transferred to the componts of suspension system | There should't be any sagging in the springs at instant of extreme compression
 |  | A-Arms | Sejal Ahmad , Mohd Iftikhar Alam | Remain well aligned and no mechanical failure | Check conditions visually after performance testing on roads with bumps | Test Track | min 15 trials | A arms |  | Lightweight strength for superior handling
 |  | Upright | Sejal Ahmad , Mohd Iftikhar Alam | Should not deform or fracture due to Excessive bending and crushing stresses | Check conditions visually after performance testing on roads with bumps | Test Track | min 15 Trials |  |  | Lightweight strength for superior handling
 |  | Drop Test | Sejal Ahmad, Mohd Iftikhar Alam | All Suspension components and linkages should be working and aligned after drop test | Lift vehicle in air from front for about 0.5 meter and then drop. Same for Rear Suspension | N/A | min 3 Trials | All the componts were aligned properly | Vehicle is durable | Drop test assesses structural durability and impact resistance
 |  | Rim | Sejal Ahmad | Rims should not deform during running | Check wheel conditions visually after vehicle running with 2 heaviest drivers and 20kg payload | 20kg payload, weighing machine | every 2km | Verify that the rims do not exhibit any deformation while the vehicle is in motion through visual inspection during operation. |  | Lightweight strength for superior handling
13 | Wheels | Tyres | Sejal Ahmad | Tyres should be in suitable conditions to run without any defects and puncture | Quality Check | N.A. | every 10km | Ensure the tires are free from defects and punctures, observing their suitable condition for safe and uninterrupted operation. |  | Traction, durability, and performance synergy.
 |  | Bearing | Sejal Ahmad | Should support & guide the relative motion of the wheel with respect to the upright without high vibrations or seizure | Check wheel conditions visually after vehicle running with 2 heaviest drivers and 20kg payload | 20kg payload, weighing machine | every 2km |  |  | support smooth operation
 |  | Upright | Sejal Ahmad | Neither structural failure nor change in camber, kingpin because of change in flange angle due to stresses. | Check wheel conditions visually after vehicle running with 2 heaviest drivers and 20kg payload | 20kg payload, weighing machine | every 2km | Upright have'nt showed any deformation or bending | Good strength | Lightweight strength for superior handling
 |  | A-Arms | Sejal Ahmad | No Bending breakage, cracks, structural damage and mechanical failure | Check wheel conditions visually after vehicle running with 2 heaviest drivers and 20kg payload | 20kg payload, weighing machine | every 2km | A arms were adjusting themselves according to the load | no cracks, no mechanical failure | Lightweight strength for superior handling
 |  | Load Bearing Capacity | Mohd Iftikhar Alam | Wheels should not bend during running | Check wheel conditions visually after vehicle running with 2 heaviest drivers and 20kg payload | 20kg payload, weighing machine | every 2km | Vehicle can bear load properly, without showing much deformation | Durability is appropriate | the load-bearing capacity is carefully designed for optimal functionality.
 |  | Tires | Sejal Ahmad | Should be at recommended inflation pressure | Check tire pressure before and after vehicle test run. | Tire-pressure gauge | One Time | Tyres were having inflation pressure | Tyres were providing good performance | Traction, durability, and performance synergy.

Sheet: DFMEA
Design Failure Modes & Effect Analysis Report 2023
Team ID |  | 23056 | Vehicle Category |  | EFFI QUE ADAS |  | Team Name | GREEN WARRIORS
SR | COMPONENT | FUNCTION | REQUIREMENT | FAILURE MODE | FAILURE EFFECT | SEVERITY (S) | MECHAINISM | FAILURE CAUSES | OCCURENCE (O) | CURRENT DESIGN CONTROL |  | Detection (D) | RPN | PERSON IN CHARGE | COMMENTS
 |  |  |  |  |  |  |  |  |  | (PREVENTION) | (DETECTION)
1 | Brake Pedals | The brake pedal is used to activate the vehicle's braking system, converting kinetic energy into heat through friction to slow down or stop the vehicle. | The brake pedal is a requirement for controlling and decelerating a vehicle by engaging the braking system, ensuring safe and efficient stopping. | structural failure due to fatigue bending and breaking | inability to operate vehicle's manual powertrain | 5 | Pedals are not able to withstand force applied by human's foot on it. | excess application of load by the the driver causes axial load to exceed the yield strength of material | 3 | choose material with high FOS and according to vehicle specification | visual inspection | 2 | 30 | Abdus Samad Suhail | Use good quality pedals, as rusting may occur.
2 | Springs | absorbs the shocks or vibrations which in turn provide comfort & safety to the driver | absorb enough amount of force on bump and droop to keep the vehicle tire contact patch on the ground | spring fractures and fails | damage to the suspension system and rough of vehicle | 7 | stress or force exceeds what the spring was designed to handle, Wrong material choice, poor finish or incorrect finish selection. | wrong choice of springs, it fails due to load exceeding the yield stress of material | 3 | choose springs according to vehicle loads and other specification | dynamic simulation | 4 | 84 | Mohd Iftikhar Alam | Accurate weight distribution for designing of springs
3 | Shaft | transfers driving torque from motor and cassette to the wheels | transfer torque to all wheels from crank set and motor in order to achieve speed of 35/km and shaft should have enough strength to bear the force applied on it due to chain and sprocket i.e. shaft should not bend or break. Shaft is of 25.3mm diameter. | bending breakage and structural failure | vehicle becomes inoperable | 8 | Applied force and torque are more than it can withstand leading to breakage and structural failure. | not analysing the tension and reaction forces by chain & plummer respectively, not selecting the proper material for the shaft to overcome the torsion and other straight forces on it | 2 | review calculation and select appropriate material with desired boundary condition | stress analysis and simulation technique | 3 | 48 | Ayush Gupta | have used a plummer block in the middle of the shaft to restrict bending and breakage.
4 | Crankarm | converts the reciprocating motion of the driver's legs into rotational motion which in turn drive the wheels | Ideally, a crank of length is chosen that would have knees working within a tighter and more efficient range of motion. Four commonly available crank arm lengths: 165, 170, 172.5 and 175mm, so a crankarm accordingy to the size and the chainrings attached to it is selected | mechanical failure | failing of manual powertrain | 7 | Mis alignment of crankarm can lead to stress concerntration on a particular area of crankarm. | improper calculation of the crank length, it could generate torque by applied force | 5 | proper calculation of crank length before assembly | stress analysis | 4 | 140 | Ayush Gupta, Ayush Gupta | Essential in cycling mechanics, providing power transfer and efficiency for optimal pedaling performance and cycling experience
5 | Chain | transfers power from the pedals to the drive-wheel of efficycle | chain's thickness has to be selected wisely. Use chain which can bear force applied to crank by human's foot. Select chain such that sprockets' pitch must match chain's pitch. | mechanical failure, breakage | inability to operate vehicle's manual powertrain | 7 | Excess force are applied on chain links than it can bear leading to failure of chain links. | the chain between the drive sprocket and the shifter of driven cassettes not straight and is leaning or slack instead, generation of excess tension in chain due to improper or no chain length calculation for required gear ratio | 6 | proper meshing of gears of sprockets with chain | regular checking and technical inspection | 2 | 84 | Ayush Gupta, Ayush Gupta | Keep greasing chain
6 | Gear shifter | acts as a component used to control the gearing mechanisms and select the desired gear ratio | require a gaer shifter which can provide more option to change torque according to the terraiin and speed requirement. We are using a cassette of 7 gear combinations. | mechanical failure, breakage of chain | vehicle becomes inoperable | 7 | stress or force exceeds what the chain was designed to handle, breakage of wire of gear shifter due to entanglement. | inaccurate gear ratio calculations for freewheel and cassette, improper adjustment of chain on the freewheel | 6 | proper lubrication, periodical check-ups & replacements, use of standard cassette | regular inspection and check before drive | 5 | 210 | Ayush Gupta, Ayush Gupta | Vital for precise transmission control, enhancing driving performance.
7 | Upright | connects the wheel to the A-arms, helps in determining the caster, camber and kingpin angle | no changes due to bending which can affect suspension geometry and angles like kingpin,castor and camber etc | structural failure, change in camber, kingpin cause change in flange angle due to stresses | steering becomes unstable off-road, it becomes hard to steer, change in kingpin, caster, camber angles, free play of wheel assembly components, bending of flanges and A-arms | 9 | stress or force exceeds what the Upright was designed to handle, Wrong material choice,Poor analysis | vertical forces during bumps, change in flange angle due to stresses, dropping he vehicle from higher positions, bending stress | 3 | choose material with high FOS and according to vehicle efficient light weight knuckle design | stress analysis during extreme bump and vibration situations | 4 | 108 | Sejal | Accurate stress concentration due to load coming from chassis and other components and use them as input in analysis software
8 | Driver Seats | provides the sitting space for driver & co-driver with desired level of comfort and safety | separate seats should be provided to individual drivers,driver seat should be thick according to ergonomics. Driver seat angle should be 32 degree from the vertical | structural failure affecting safety (driver restraint system not transferring the loads through nodes resulting in stress concentration further causing failure of member due to residual stresses) | reducing the overall strength of the chassis, reduced driver safety, lower maneuverability and handling | 4 | Excessive force on the mounting points of the driver's seat, | excess load leading to bearing stresses | 3 | proper fitting and material according to correct specification of load, follow good engineering practices | dynamic simulation, static analysis of the chassis | 3 | 36 | Sarim, Adeel | In vehicle ergonomics, ensuring comfort, support, and optimal posture for enhanced driving experience and safety
9 | A-arms | connects the the suspension system to the vehicle frame | no changes due to bending which can affect suspension geometry, flange angles | Bending breakage, cracks, structural damage and mechanical failure | damage to the suspension system and rough operation or non-operation of the vehicle | 8 | Uneven Tire wear, Suspension misalignment, steering wheel vibrations | axial stress exceeds, yielding stress of material due to excess load and impact loading | 3 | choose material with high FOS and according to vehicle | effective design and analysis | 4 | 96 | Sejal | Crucial components in suspension systems, providing structural integrity and precise control for optimal vehicle handling .
10 | Steering Column | connects the steering mechanism to the steering wheel and transmits the driver's torque to the mechanism | the steering column is a crucial component in a vehicle responsible for transmitting driver input to the steering system, enabling control of the vehicle's direction. | mechanical failure, excess vibration | steering failure, safety of driver and other components | 9 | excessive load/stress during rigorous turning and bumping | debris leading to steering column failure | 8 | verification of desired specification and testing | stress analysis | 4 | 288 | Abdus Samad Suhail | Integral to vehicle control, ensuring precise and reliable steering for optimal driving functionality.
11 | wheel hub | Provides a mounting point for a vehicle's wheel and connects it to the axle | Facilitates smooth rotation and supports the vehicle's weight, enabling efficient and controlled movement. | Cracks or fatigue, corrosion | Failure can result in compromised vehicle stability, leading to loss of control and increased risk of accidents. | 8 | Cyclic loading from the vehicle's weight and driving conditions can lead to material fatigue, causing cracks or deformation in the hub | Overloading, poor maintenance, Corrosion, impact damage, manufacturing defects and improper installation | 3 | conduct regular inspections for wear and damage, and adhere to recommended maintenance schedules | stress analysis | 4 | 96 | Sejal | Critical in the wheel assembly, ensuring reliable rotation, load-bearing capacity, and overall performance for optimal vehicle functionality.
12 | Tires | support the vehicle weight, absorb road shocks, transmit traction, torque and braking forces to the road | withstand impact loads when dropped, stablity in air pressure When the vehicle is in motion, proper grip for braking in desired distance | mechanical failure | inability to operate vehicle | 8 | inadequate air pressure in tires will lead to uneven tire contact patch | puncture by foreign debris | 5 | verification of proper specification and testing | visual detection | 2 | 80 | Sejal | Essential for vehicle performance, providing traction, durability, and reliability for optimal functionality.
13 | Bracket | contains firmly the powertrain components of a vehicle | should contain a spindle to which the crankset attaches, and the bearings that allow the spindle and crankset to rotate Chainrings and pedals attach to the cranks. | structural failure, bending and breakage | bracket fracture loading to dislocation of mechanical/structural components which in turn leads to mechanical and structural component damage, damage to roll cage as a whole | 8 | Excessive stress on craforce on bracket due to crank arm. | bearing and yielding stress caused by excess load and constant vibration | 4 | choose material with high FOS, effective design and analysis | static stress analysis | 3 | 96 | Ayush Gupta | Critical for structural support,ensuring stability.
14 | Bearing | bear heavy loads and reduce friction | rotate smoothly | high vibration, bearing seized | failed sub-systems, overheat and overload, high repair cost | 7 | improper rotation of bearing, rotation speed decreases. | improper lubrication for grease, improper mounting, incorrect or insufficient lubricant, lack of tools and training | 2 | improved materials, proper time to time maintenance | static stress analysis | 4 | 56 | Sejal | Ensuring reliable rotation and support for optimal functionality
15 | Body Panel | designed to withstand the impact in case of a front-or rear-end collision | all joints must be made properly to bear collision | structural failure | loss in aesthetics | 4 | excessive collision force, Corrosion due to oxidation | water damage, electrical failure, colliding of foreign object, impact loading | 3 | choose material of high FOS | visual detection | 3 | 36 | Munazir, Farhan | Integral to design, ensuring structural integrity and aesthetic functionality in vehicle construction
16 | Vehicle Electrical Components | operates various electrical & electronics devices | all electronic and electrical components work as desired with proper safety precautions in case of failures | electrical failure | endangers the driver's safety due to contact with electricity | 9 | sensors take data from environment, then actuators work as programmed and all connections are made to batteries which then powers the components for their desired functions. | water damage, electrical failure | 8 | proper insulation should be provided and wiring should be done properly | temperature sensor will install to measure the temperature of battery & current sensor have to be install ed for measuring the current withdrawn from battery | 4 | 288 | Ayush Gupta | Essential for functionality, ensuring optimal performance and reliability.
17 | Rim | support and seal the tire to the wheel | friction provided by the tyre contact is neccesary to turn the wheels for motion of vehicle Rim magnifies the amount of force applied which provides the leverage | mechanical failure | inability to operate vehicle | 8 | rotation of Tire stops | damage by debris | 3 | verification of proper specification and testing | visual detection | 5 | 120 | Sejal | Crucial in wheel construction, ensuring strength, balance, and performance for an optimal riding experience
18 | Brake Lever | provide space for application of stopping forces and enlarge them, distributes equal stopping forces to front wheels | must have enough strength to bear excessive force applied during emergency situations | brake lever jammed, loose, uneven stretch of brake wire | vehicle does not stop, partial braking/stop, wheels stop at different time causes vehicle may roll or yaw | 6 | very little or no transfer of braking force due to damage in brake lever or improper connection | inadequate corrosion on mechanical parts, loosening of fasteners, uneven stretch of brake wires | 7 | use lubricants frequently whenever decide, tight all fasteners properly, use standard lever and review calculation | technical inspection & durability test | 3 | 126 | Abdus Samad Suhail | Use brake lever in which lever locking parts must not distort easily.
19 | Brake Wire | transmits brake fluid from the master cylinder to calliper | it must work smoothly. It must not bend easily. | lesser brake oil, wire break out | irregular braking, driver felt uncomfortable, vehicle goes completely out of driver's control | 5 | reduced or no transfer of braking force due to damage or improper connection of brake wire. | improper mounting at ends, inappropriate routing, large tension, wire being faded | 7 | ensure proper mounting at ends and review routing, use standard wire | durability test | 3 | 105 | Abdus Samad Suhail | Use good quality stainless steel wires.
20 | Brake Calliper | pushes pads against rotor so that rotor stops rotating | properly designed and must have enough strength to bear excessive force during emergency situations. Brake pads must not be worn out. | small force applied than required, a much harder push than required | partial braking, vehicle stops well but the driver feel uncomfortable | 5 | reduced braking due to worn out of brake pads. | pad wear out, less gap b/w rotor and pad | 7 | proper fitting and material according to correct specification of load | visual inspection | 5 | 175 | Abdus Samad Suhail | Use good quality calipers with enough strength of barke pads to resist any distortion.
21 | Brake Lights | indication to vehicles in rear of applying brakes | must have enough brightness to help other vehicle to identify braking is taking place. | not glowing during breaking | vehicle gets trucked from behind by other vehicles | 2 | brake lights are not fully functional. Maybe defect in electronic circuit or wiring. | electrical wires not connected properly, fused lights | 7 | proper insulation should be provided and wiring should be done properly | visual inspection | 4 | 56 | Abdus Samad Suhail | Use good quality LED lights and ensure proper soldering is done in connection of wires.
* Add more rows if required but after last column of this format
22 | Frame | Load bearing structure of the vehicle | withstand load from different components in static and dynamic state | Structural failure, bending and breaking of frame | Overall damage to roll cage. Frame breaks or bends, Driver's saftey is endangered | 10 | reaction forces from the wheel during acceleration and braking, aerodynamic wind forces and road shocks through the suspension. | Axial stress exceeds, yielding stress of material due to excess load and impact loading | 6 | choose material with high FOS, effective design and analysis ; constant testing | static stress analysis and simulation | 5 | 300 | Munazir, Farhan | Core structure ensuring stability and optimal performance in all riding conditions.
